Bongorian/chiptune-usb-cv/docs/routing-notes.txt

配線方針 — JLCPCB Economic PCBA / 4層 FR4 1.6 mm / 外層銅 1 oz・内層銅 0.5 oz
2026-10-05

JLCPCB公表値と設計値
- 外層1 ozの最小線幅・線間隔は0.10 mm。設計の絶対最小は0.15 mm。
- 通常の銅間隔0.15 mm、CV・音声0.20 mm、絶縁側MIDI0.50 mm。
- 基板外周から銅まで0.50 mm。四隅R3と角中心のM2穴は維持。
- 通常ビアは外径0.60 / 穴0.30 mm、電源ビアは0.80 / 穴0.40 mm。
  RP2040・共有データバス・局所GNDの引き出し用は外径0.50 / 穴0.20 mm (環状銅0.15 mm)。
- ビアは表裏ともテンティング。SMDランド内のビア穴は禁止。
- PTH環状銅幅0.18 mm以上、部品穴同士0.45 mm以上。
- 部品実装は表面1面のEconomicを想定。DIP音源IC・OLEDは手実装。

信号グループ別の基本配線幅 (mm)
USB D+/D− 0.25、ペア間隔0.15
パラレルデータ・制御 0.15
QSPI 0.15
GPIO→33Ωのクロック支線 0.15、33Ω→音源のクロック 0.20
水晶 0.15 (銅間隔0.20)
CV・バッファ・ADC入力 0.25 (銅間隔0.20)
音声・ミキサー 0.25 (銅間隔0.20)
ライン出力 0.30 (銅間隔0.20)
MIDI絶縁側 0.25 (銅間隔0.50)
ゲート 0.20
3.2 Vロジック 0.45、1.1 Vコア 0.35
音源5 V幹線 0.75、アナログ5 V 0.50
USB VBUS幹線 1.00、昇圧SW 0.75
GND幹線 0.50、端子からGND面への短い接続は0.25。内層2をGND面とし表裏GND面を併用
その他低電流デジタル信号 0.15

局所的な幅の縮小
- 細ピッチICとUSB-C端子を出る部分のみ0.15 mm以上を許可。
- TPS61023のVINは低電流のICバイアス支線。専用領域だけ0.25 mm以上。
- USB保護素子・LDOのVBUS端子支線は0.25 mm以上。
- 基本幅と局所縮小は.kicad_pro/.kicad_druに保存。
- 配線対象96ネットと未使用18端子の個別ネットを19クラスに分類。
- 全ネットの指定幅・実際の幅・配線長・ビア数は outputs/routing-widths.csv に記録。

優先配線
- 共有D0..D7は音源ソケット間を裏面の平行配線で接続し、ソケット端子からは表面で引き出す。
- SAA1099 pin10..17のデータは基板D7..D0へ接続。GPIO0..7は基板D7..D0へ接続。
  GPIOの8bitポート出力値は論理バイトそのまま。個別PIN_Dn書込み用はreverse8。
  firmware/sound_bus.h に両方の書き込み用ヘルパーを定義。
- USB-Cの裏表両接点→ESD→27 Ω→RP2040を先に配線。
- 水晶は表面のみで接続し、信号ビア0。水晶直下の裏面と内層1に信号・ビア禁止領域を設ける。
- 外形配置を維持しながらY1を180度回転し、R1/R27の同寸法本体の位置を交換。
  同じ15 pFのC1/C2の接続先も交換して、水晶配線の交差を解消。
- 昇圧SW配線と入出力コンデンサの電流ループを先に確保。
- 水晶Y1のGND端子4とC19/C13/R6のGNDはベタの細い橋に頼らず、端子から内層GND面まで明示的に接続。
- GND面は最終配線後に再充填し、信号線・ビア・穴に対する間隔を検査。

確認範囲
USBの0.25 mm幅/0.15 mm間隔はこの4層板の配線寸法目標。
90 Ωの製造保証や電磁界解析による保証を意味しない。JLCPCBの
インピーダンス管理サービスは4層以上が対象。USBはFull Speed用途。
層構成は F.Cu（部品・信号）、In1.Cu（信号）、In2.Cu（GND）、B.Cu（信号・GND）。
4層化により2層版より基板製造費が上がる。2層途中版は variants/usb-cv-2layer-routing/ に保存。
DRC 0、未接続0、回路図一致0、ERC 0を確認。
GerberとPCBA下書きは outputs/jlcpcb/。部品選択・回転・在庫は発注前にプレビューで確認。
実機ファームウェア、試作による電源・音声・CV校正の評価は未完了。

公式資料
https://jlcpcb.com/capabilities/pcb-capabilities/
https://jlcpcb.com/capabilities/pcb-assembly-capabilities
