Bongorian/chiptune-usb-cv/mechanical/previews/mechanical_drawing.pdf

# CHIPTUNE USB/CV / ENCLOSURE

Dimensions in mm / diagram not to scale / drawing-only annotations

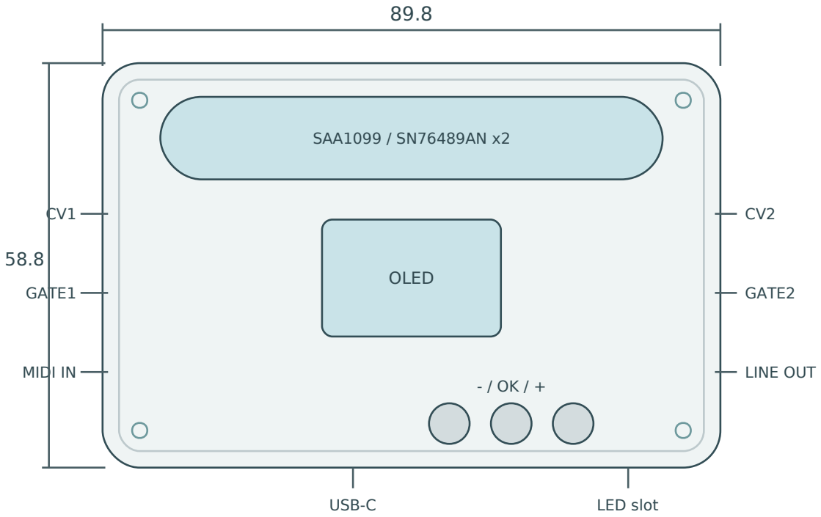
[picture p3: figure]
GATE1; MIDI IN; GATE2; LINE OUT; USB-C; LED slot; SAA1099 / SN76489AN x2; OLED

TOP / PCB hole centres: (3,3), (82,3), (3,51), (82,51)
Four M2 x 10 screws from the underside; heat-set inserts in lid posts. Blue circles: PCB holes, hidden under the assembled lid.

23

SIDE / TRS relief: diameter 9.5 Port pitch: 11.5 / seam at jack axis

### HEIGHT STACK

PCB bottom: 6.0

OLED bottom: 12.6

Open bezel: 19.0 - 21.0

Separate OLED module on 5 mm PCB spacers

## FIT COUPON / 58 x 16 x 5

2.9 | 3.0 | 3.1 | 3.2 | 3.3
5.7 | 5.9 | 6.1

Blind holes: insert pilot diameters Through holes: button guide diameters

## PRINT PARTS

Base x1 / bottom on bed
Lid x1 / exterior face on bed
Button cap x3 / head face on bed Open IC / OLED apertures; no covers Case M2 inserts: OD 3.5, length 3.0

Prototype fit required: insert bore, switch travel, socket height and actual module dimensions.
