Bongorian/chiptune-usb-cv/firmware/LEVELS_AND_PITCH.md

# v0.10 音量と音程の確認

初期配置は `MIDI 10`。MIDI ch1–6はSAAの各1音、ch7–9は左右SNの同番号トーンの各1音、ch10は左右SNのノイズ1音です。各chは単音で、SNは同じノートをL/Rへ送ります。PAN中央で両側同音量、CC10でL/Rの音量比を変えます。SAAもCC10で左右へ振れます。通常のMIDI受信音程を下げる移調は入れていません。

## 音程

`src/sound_math.c`の1/256半音LUTを単一エンジンで使用し、SAAは専用レジスターLUTへ変換します。MIDI note 0=C-1、69=A4=440 Hz。オクターブ番号はDAWによって異なるため、試聴時はノート番号とHzも確認してください。初期試聴はnote 45=A2=110 Hzです（従来は48=C3=130.81 Hz）。初期音色SAA TONE／SN MONOは移調0、スイープ0、ビブラート0、デチューン0です。ENVやSN STACKから始まって音程の意味が変わる構成をやめました。

回路の基準クロックはSAA=8 MHz、SN初期値=2 MHzです。RP2040=128 MHz、SAA PWMのwrap=15、SNのPIO分周設定と照合しています。SNクロックFXを有効にすると意図的に音程が変化します。

| 音源 | 出力周波数 | 初期クロックでの範囲 |
|---|---|---|
| SAA通常トーン | `8,000,000 × 2^octave / [512 × (511 − register)]` | 約30.58–7,812.5 Hz。MIDI 23–118が範囲内 |
| SN通常トーン | `clock / (32 × divider)` | 2 MHzでは約61.09 Hz以上。MIDI 35以上が範囲内 |
| 純SAA ENV | 上記のENVクロックを形状・段数で分周 | 通常トーンと異なる。16段三角の上限約488 Hz |
| SN PULSE（Periodic＋Tone 3） | `clock / (32 × Tone3 divider × 15)`、パルス幅約1/15固定 | 2 MHzでは約4.07–4,166.7 Hz。高音域の分周誤差が増える |
| SNホワイトノイズ | 固定レート、または音程からノイズの更新速度へ変換 | 楽音の基音は保証しない |

通常トーンの分周式には一律1オクターブの誤りは見つかりませんでした。基準テーブルを共通化し、110/130.8128/261.6256/440/880 Hzと全128ノートの換算、SAAの範囲内誤差4 cent未満を回帰テストに追加しました。範囲外は最小／最大へのクランプを維持します。SNの高音域では10 bit分周の量子化誤差が大きくなります。

実装から出力した[128ノートの周波数表](dist/Pitch_Table.csv)にレジスター値・実際の計算周波数・cent誤差・クランプ有無を収録します。SN PULSE用のTone 3分周値・周期周波数・誤差も併記します。再生成はホストビルド後に `build/tests/pitch_export > firmware/dist/Pitch_Table.csv`。

## 音量補正の根拠

資料は[Philips/Mullard SAA1099、1984年8月](https://sam.speccy.cz/systech/saa-1099_data_sheet.pdf)のp.4–8、11–15、および[TI SN76489AN](https://map.grauw.nl/resources/sound/texas_instruments_sn76489an.pdf)のTone Generators、Electrical Characteristics、Fig.2です。回路は `routed/Chiptune_USB_CV.kicad_pcb` と生成元 `scripts/design.py` のオーディオ段を照合します。

- SAA：IREF抵抗10 kΩ、左右負荷1.5 kΩ。R42=10 kΩ、R43/R44=1.5 kΩを基板データでも確認。各出力から1 µF＋22 kΩでミキサーへ入り、帰還抵抗10 kΩ。公称IREF=250 µAを置くと、1音最大時の片側出力は `250 µA × 1.5 kΩ × 10 kΩ / (22 kΩ + 1.5 kΩ) ≈ 0.1596 Vpp`。1.5 kΩの出力抵抗による入力22 kΩへの負荷を含みます。
- SN：Fig.2の内部合計電流160 µAと17 kΩ帰還、4つの等重み音源から、1音の公称振幅を `160 µA / 4 × 17 kΩ = 0.68 Vpp` と推定します。外部ミキサー後は `0.68 × 10/22 ≈ 0.3091 Vpp`。
- よってSNの線形ゲインに `0.1596/0.3091 ≈ 0.51627`（約−5.74 dB）を掛けてから2 dB刻みへ量子化します。フルスケールでは約−6 dBになります。SAAは直線16段階です。音色LEVEL、ベロシティ、ADSR、CC7/11、PANとチップミックスを掛けた後、最終レジスターへ変換します。

**これは公称モデルでの合わせ込みで、実機の同音量を保証する値ではありません。** SAAの10 kΩによるIREFは個体差があり、データシートの1音電流は155–270 µAです。SNのFig.2は絶対音量の保証規格ではありません。波形・ノイズ・ENVのRMSと聴感も同一ではありません。1.5 kΩ負荷はSAAの同時発音時のコンプライアンスも実機確認が必要です。ファームウェアでアナログ段の飽和や抵抗値の問題を解消することはできません。

旧版のSAA 80/SN 70というチップミックスの差は新初期配置で100/100へそろえ、補正を一箇所へ集めます。MASTERは70、音色LEVELは65のままです。PAN中央ではSAAとSNを**片側の出力レベル**で比較します。中央から端へ動かす途中はセンター減衰なしPANです。

## 実機での詰め方

1. MIDI 10でch1 SAA TONEとch7 SN MONOを別々に鳴らす。note 69、velocity 127、CC7/11=127、CC10=64。LEVEL/SUSTAIN=100、ATTACK/DECAY=0、変調OFFにそろえる。
2. 同じ負荷（10 kΩ以上）でLINE OUTの片側ずつを測定する。440 Hzの基本周期、VppとAC RMSを記録する。L/Rとも確認する。
3. SNの補正係数は `新係数 = 現係数 × SAA実測RMS / SN実測RMS`。CMakeの `CHIPTUNE_SN1_TRIM`（左）／`CHIPTUNE_SN2_TRIM`（右）で独立指定し再ビルドする。例 `-DCHIPTUNE_SN1_TRIM=0.50f`。2 dB刻みのため細かな差は残る。音色のLEVELは用途に合わせて調整する。
4. 全ch同時、低音、高音、PAN両端、ENVとノイズでも飽和・音切れ・左右差を確認する。

PCテストは送出レジスターと公称モデルを検証します。実機での出力測定・聴感比較は未実施です。
