Bongorian/chiptune-usb-cv/firmware/assets/oled-screens.png

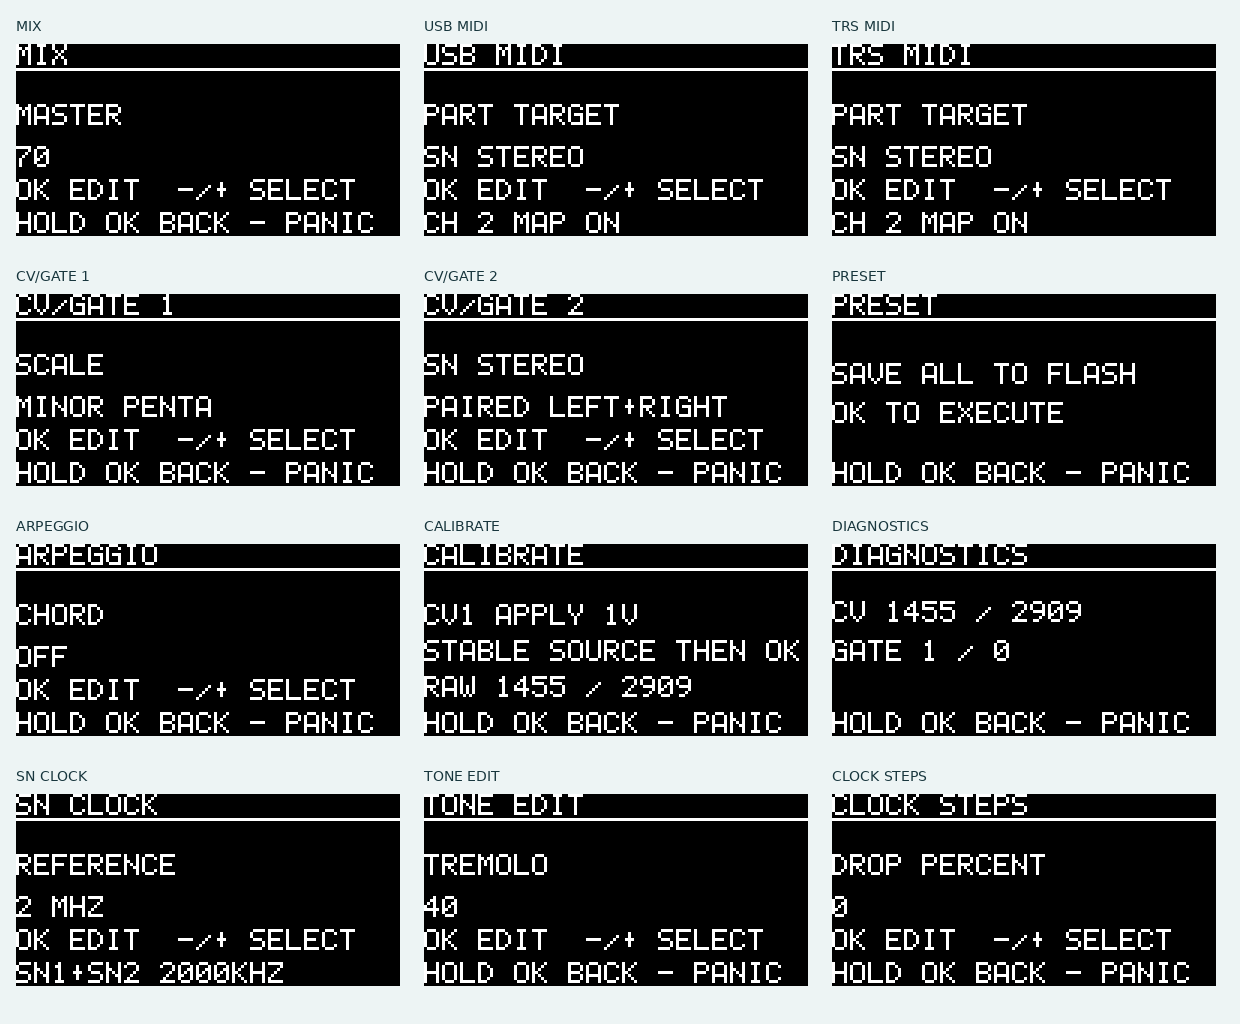
firmware/assets/oled-screens.png
