Bongorian/chiptune-usb-cv/firmware/assets/ui-v05.png

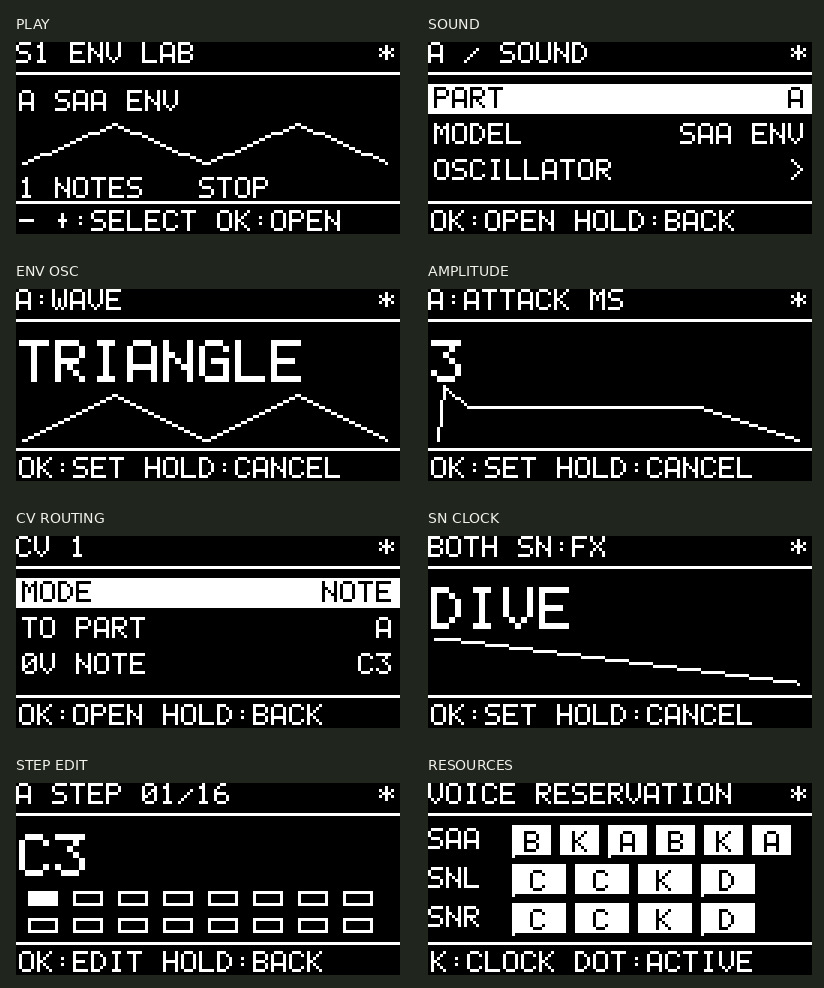
firmware/assets/ui-v05.png
