Bongorian/chiptune-usb-cv/firmware/assets/ui-v06.png

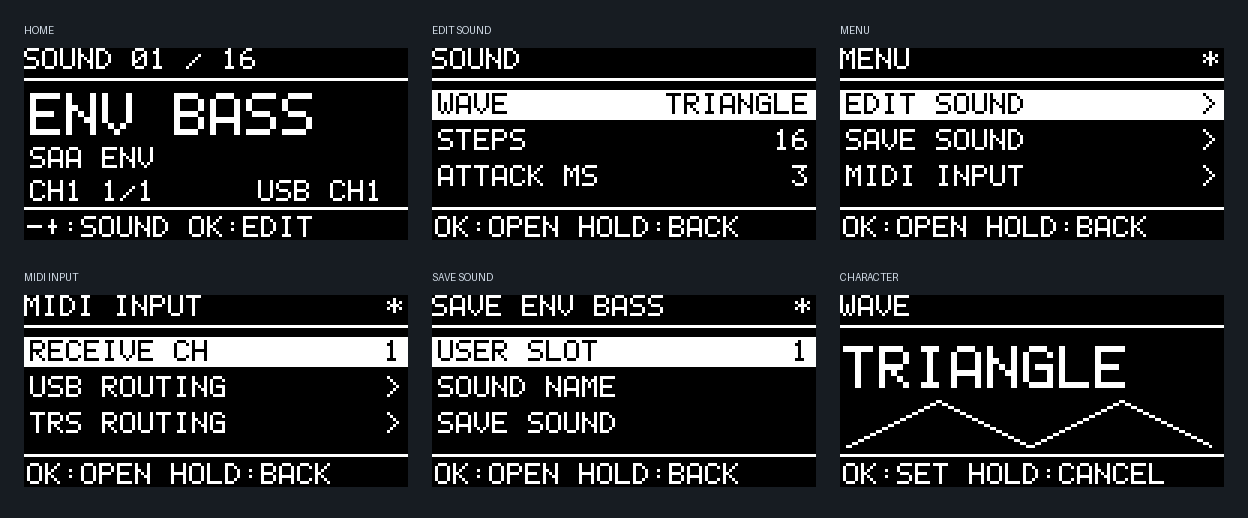
firmware/assets/ui-v06.png
