Bongorian/chiptune-usb-cv/firmware/assets/ui-v07.png

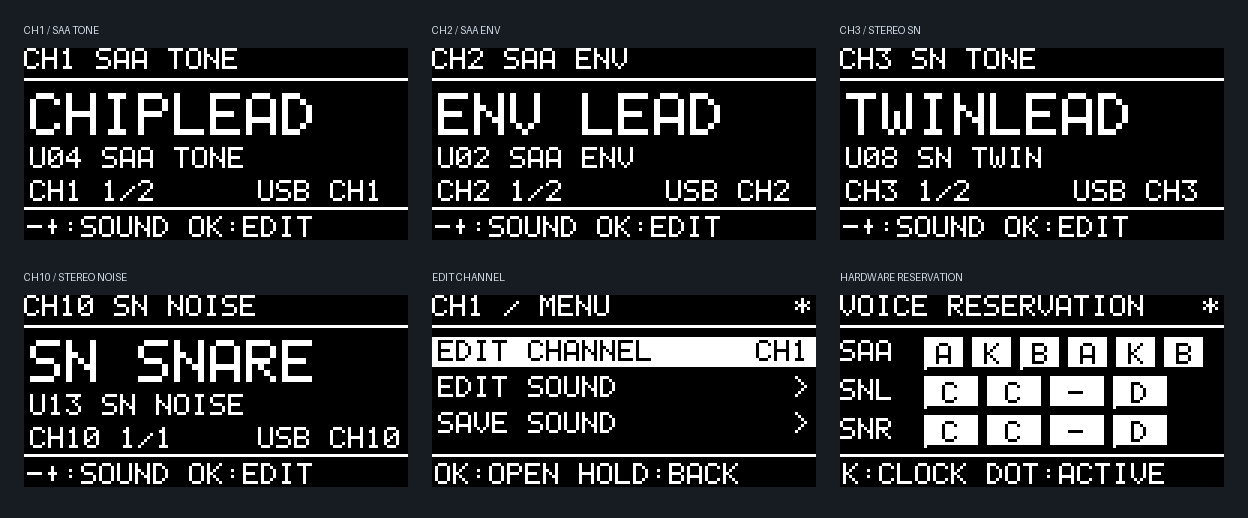
firmware/assets/ui-v07.png
