Bongorian/chiptune-usb-cv/firmware/assets/ui-v08.png

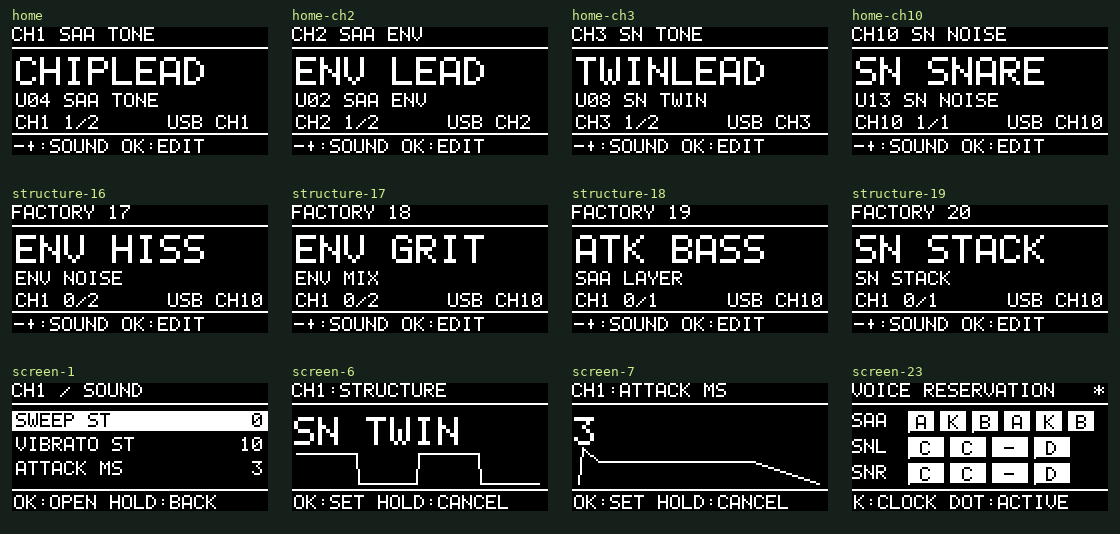
firmware/assets/ui-v08.png
