Bongorian/chiptune-usb-cv/firmware/assets/ui-v09.png

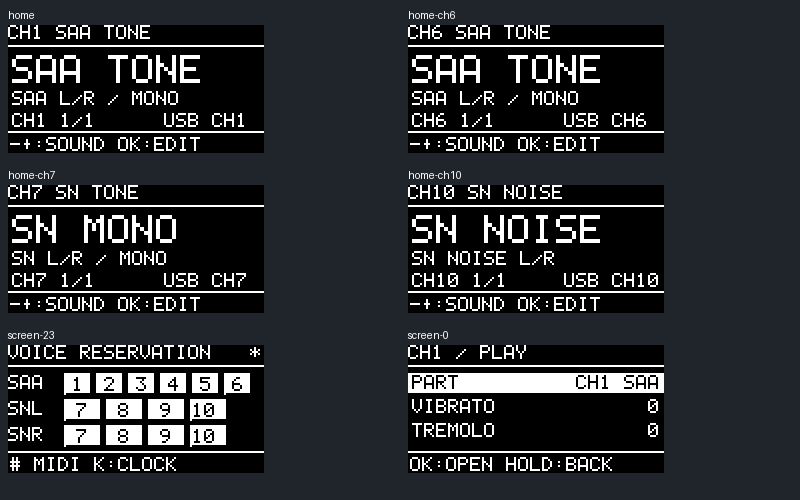
firmware/assets/ui-v09.png
