Bongorian/chiptune-usb-cv/firmware/assets/ui-v10.png

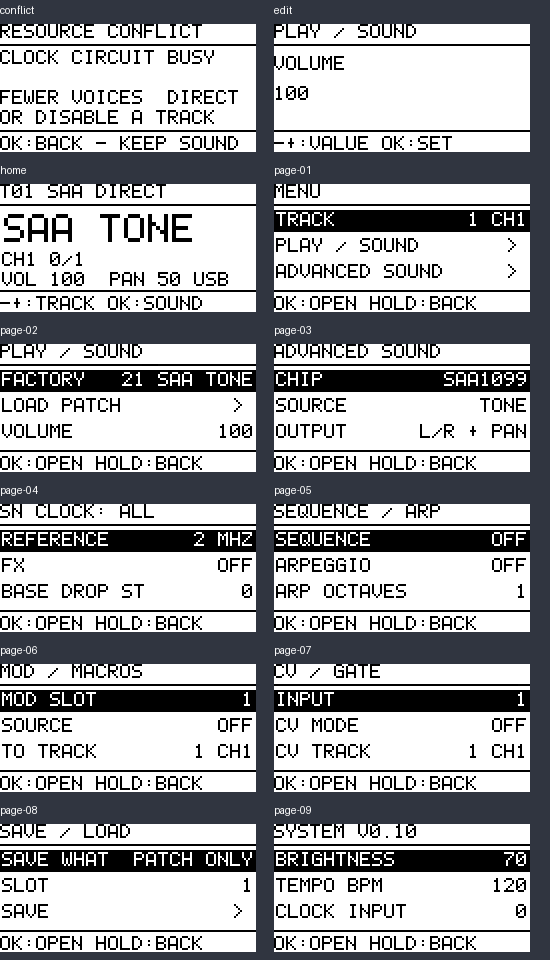
firmware/assets/ui-v10.png
