Bongorian/chiptune-usb-cv/firmware/assets/ui-waves-v10.png

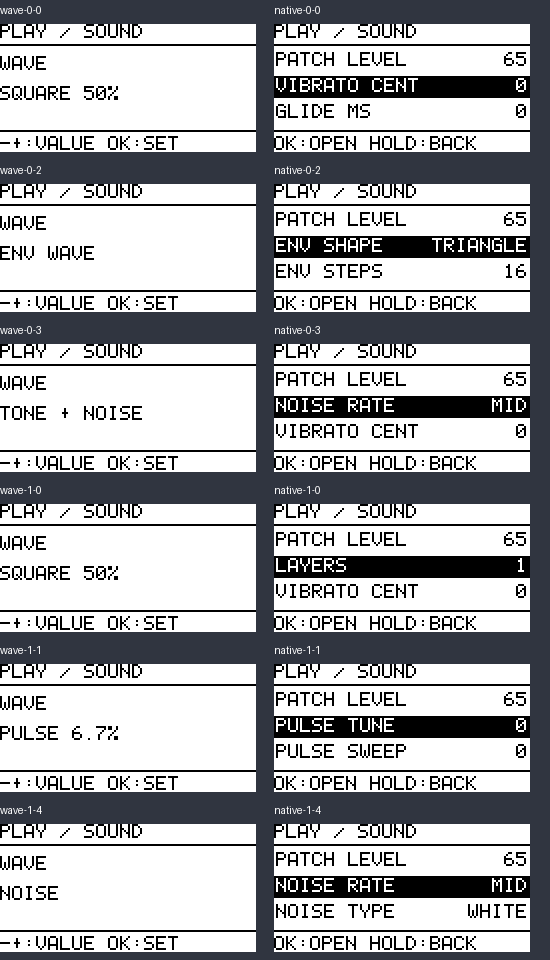
firmware/assets/ui-waves-v10.png
