Bongorian/chiptune-usb-cv/mechanical/previews/base_inside.png

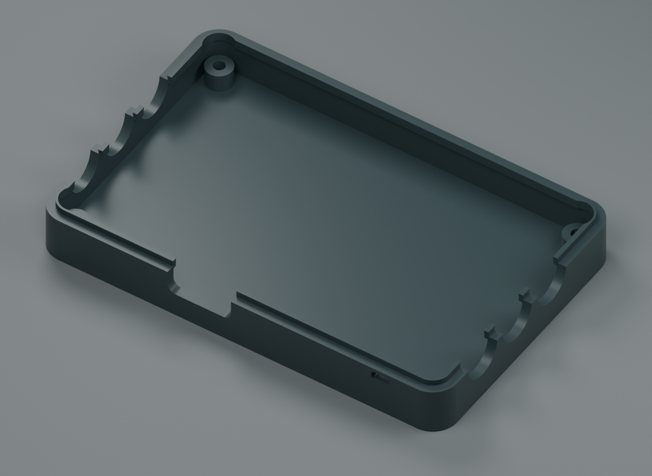
mechanical/previews/base_inside.png
