Bongorian/chiptune-usb-cv/mechanical/previews/exploded.png

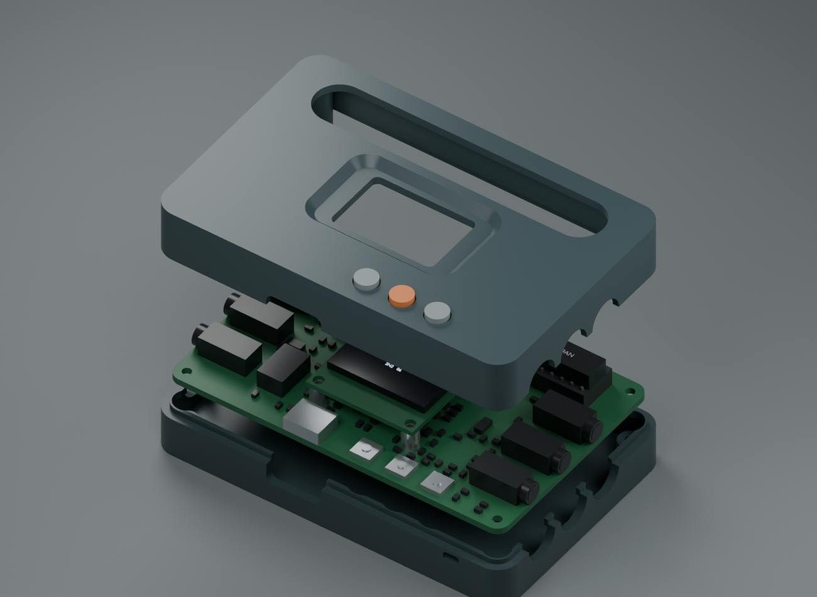
mechanical/previews/exploded.png
