Bongorian/chiptune-usb-cv/mechanical/previews/mechanical_drawing.png

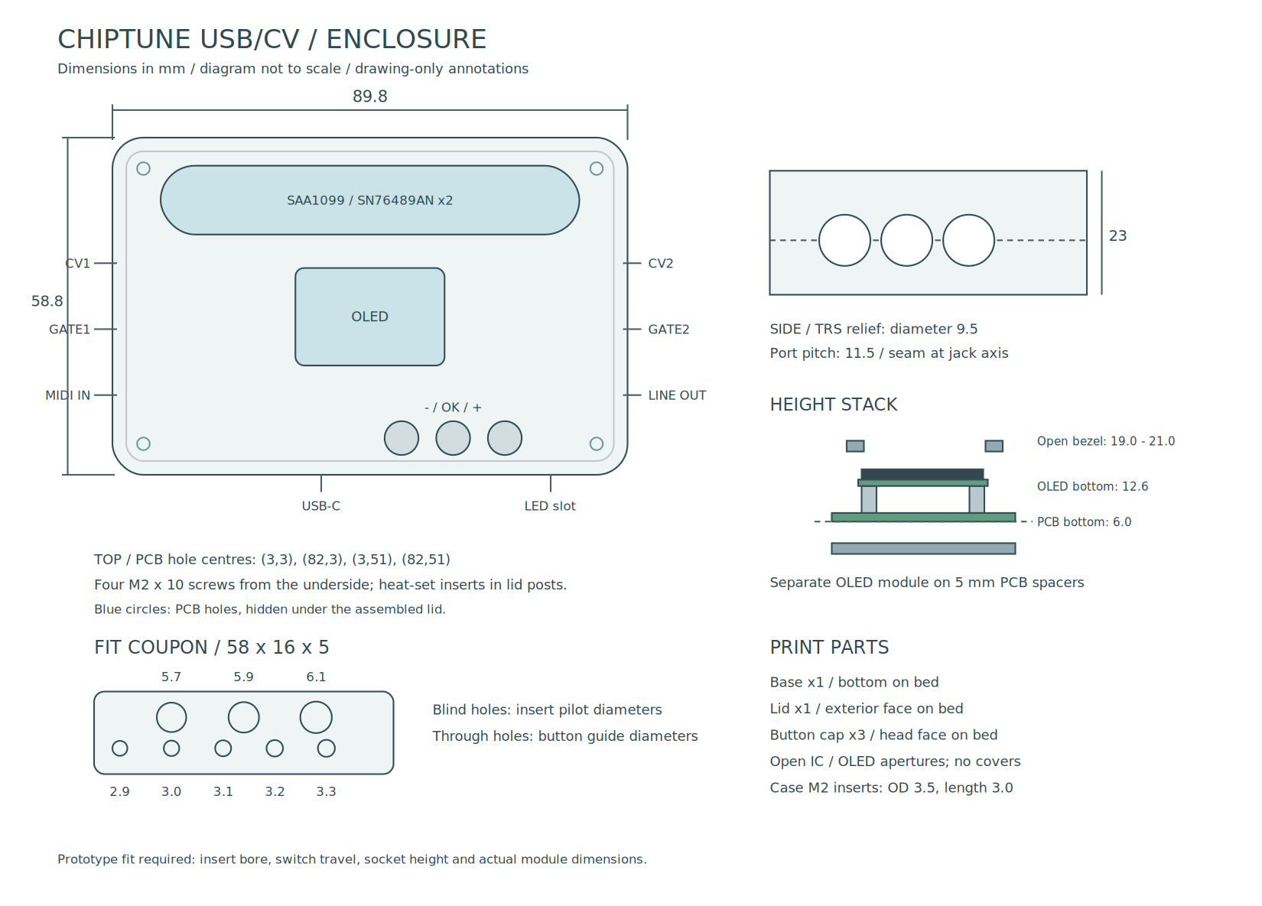
mechanical/previews/mechanical_drawing.png
