Bongorian/chiptune-usb-cv/mechanical/previews/top.png

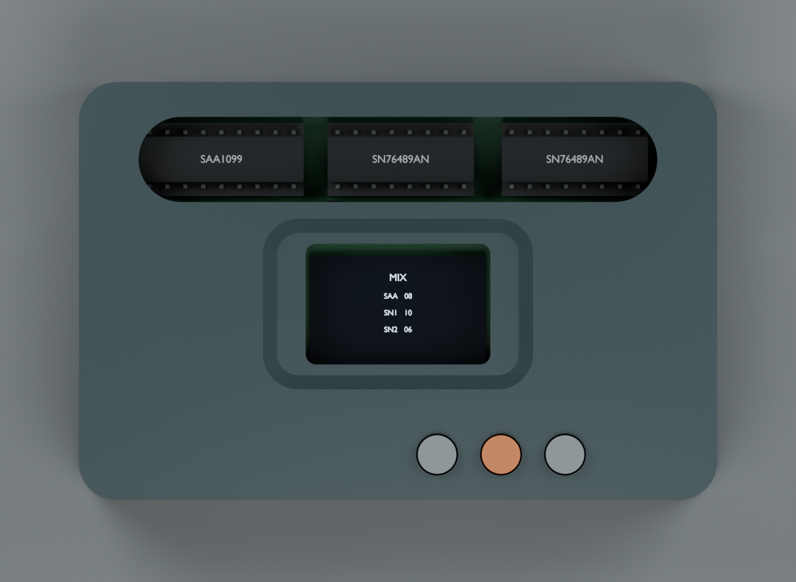
mechanical/previews/top.png
