Bongorian/chiptune-usb-cv/outputs/jlc-one/reference/Placement_Pin1.png

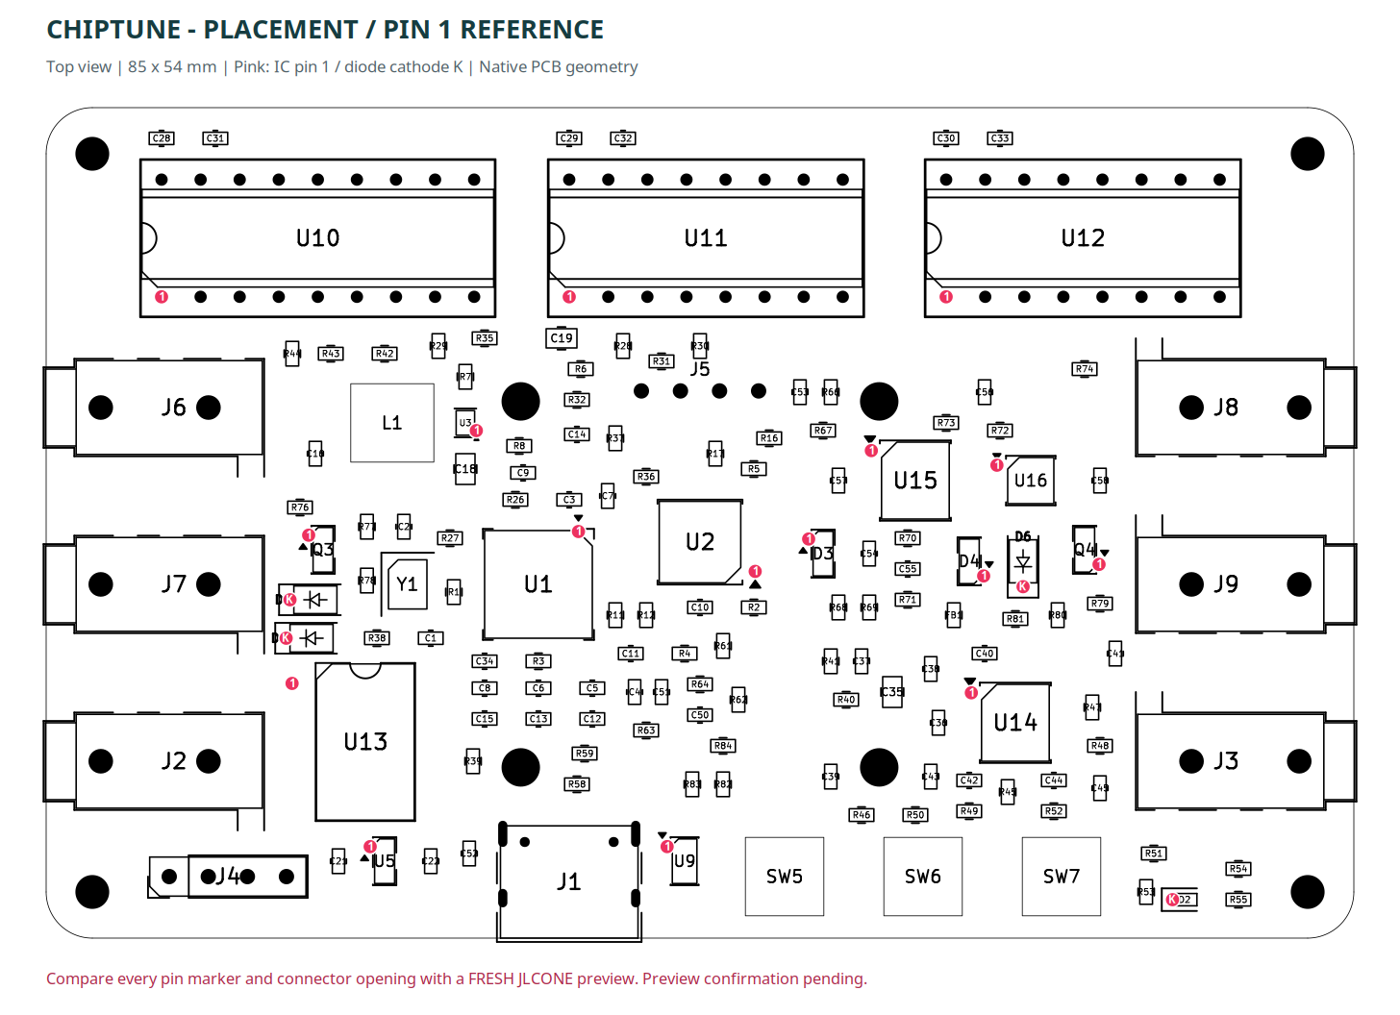
outputs/jlc-one/reference/Placement_Pin1.png
