Bongorian/chiptune-usb-cv/outputs/review/routing-ground.png

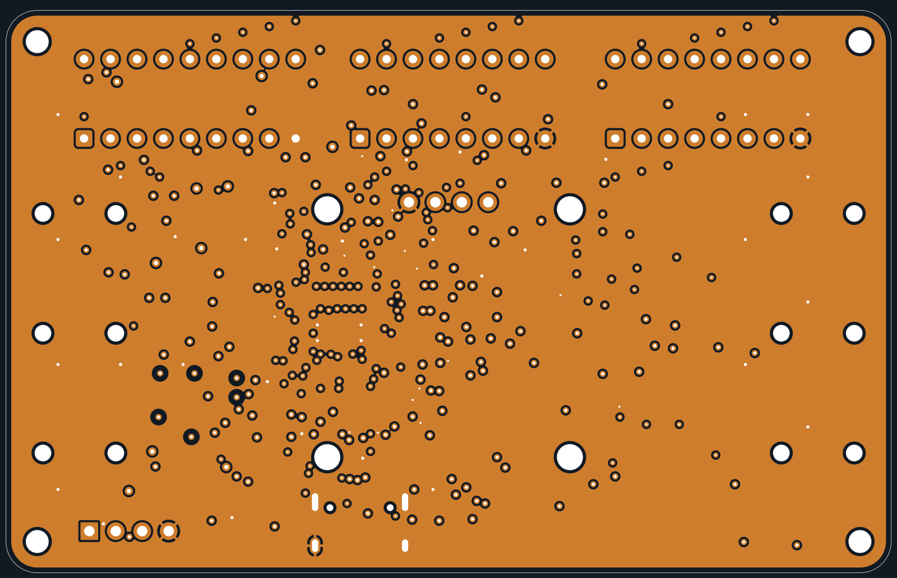
outputs/review/routing-ground.png
