Bongorian/chiptune-usb-cv/outputs/review/routing-inner1.png

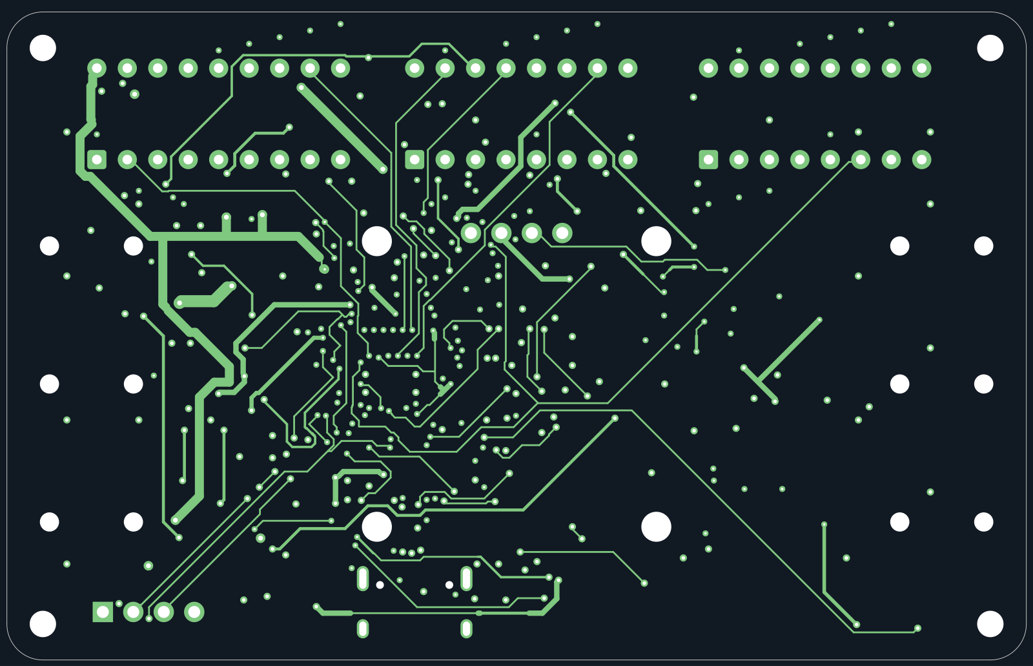
outputs/review/routing-inner1.png
