Bongorian/chiptune-usb-cv/outputs/review/routing-traces-back.png

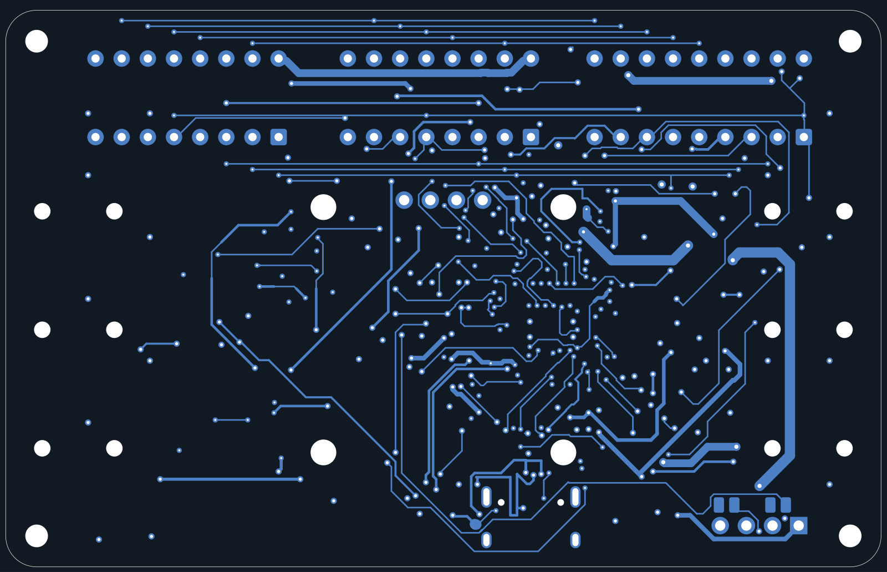
outputs/review/routing-traces-back.png
