Bongorian/chiptune-usb-cv/outputs/review/routing-traces-front.png

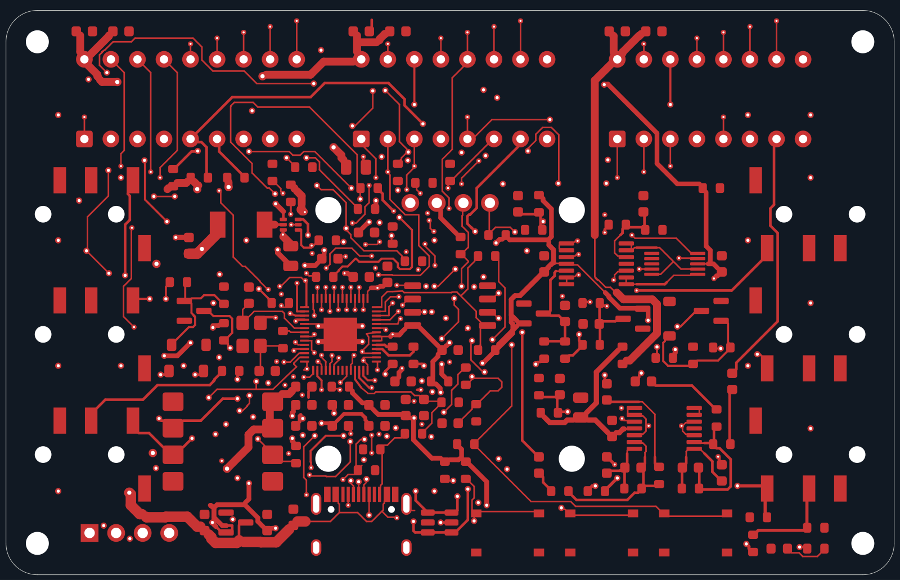
outputs/review/routing-traces-front.png
