Bongorian/chiptune-usb-cv/outputs/review/rp2040-closeup.png

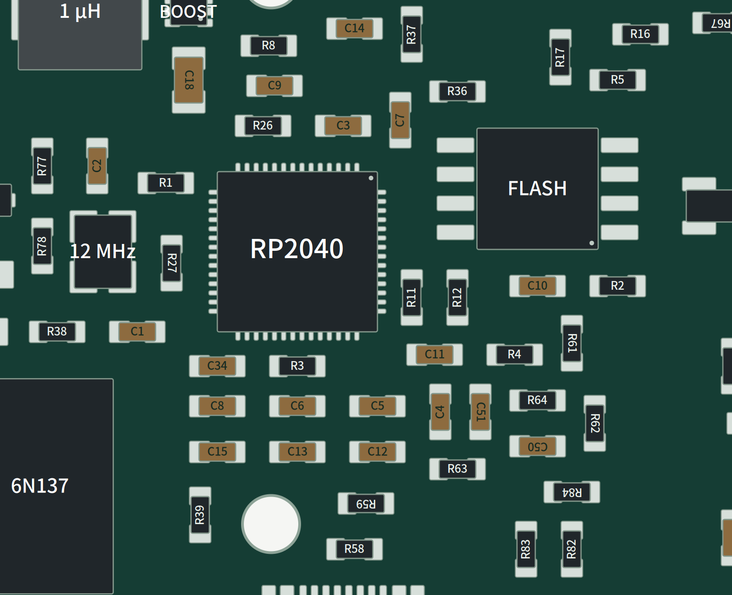
outputs/review/rp2040-closeup.png
