Bongorian/chiptune-usb-cv/outputs/review/signal-flow-placement.png

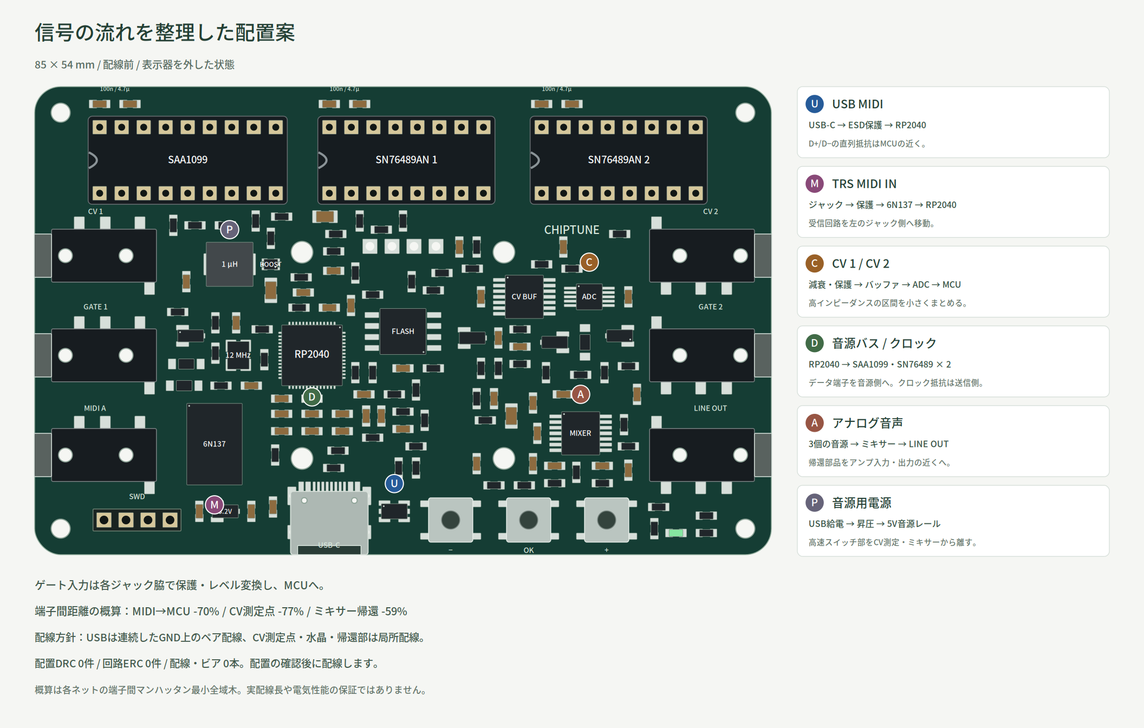
outputs/review/signal-flow-placement.png
