Bongorian/chiptune-usb-cv/outputs/engineering_bom.csv

Reference | Value | Footprint | LCSC | Side | Notes
U1 | RP2040 | Chiptune:Board_U1 | C2040 | F
U2 | W25Q16JVSSIQ | Chiptune:Board_U2 | C131025 | F
Y1 | ABM8-272-T3 12MHz | Chiptune:Board_Y1 | C20625731 | F
R1 | 1k | Chiptune:Board_R1 | C21190 | F
C1 | 15p C0G | Chiptune:Board_C1 | C1644 | F
C2 | 15p C0G | Chiptune:Board_C2 | C1644 | F
R2 | 10k | Chiptune:Board_R2 | C25804 | F
R3 | 10k | Chiptune:Board_R3 | C25804 | F
C3 | 100n | Chiptune:Board_C3 | C14663 | F
C4 | 100n | Chiptune:Board_C4 | C14663 | F
C5 | 100n | Chiptune:Board_C5 | C14663 | F
C6 | 100n | Chiptune:Board_C6 | C14663 | F
C7 | 100n | Chiptune:Board_C7 | C14663 | F
C8 | 100n | Chiptune:Board_C8 | C14663 | F
C9 | 100n | Chiptune:Board_C9 | C14663 | F
C10 | 100n | Chiptune:Board_C10 | C14663 | F
C11 | 100n | Chiptune:Board_C11 | C14663 | F
C12 | 100n | Chiptune:Board_C12 | C14663 | F
C13 | 100n | Chiptune:Board_C13 | C14663 | F
C14 | 1u | Chiptune:Board_C14 | C15849 | F
C15 | 1u | Chiptune:Board_C15 | C15849 | F
R4 | 10R | Chiptune:Board_R4 | C22859 | F
R5 | 1k | Chiptune:Board_R5 | C21190 | F
J4 | SWD | Chiptune:Board_J4 |  | F | Hand solder, optional
U3 | TPS61023DRLR | Chiptune:Board_U3 | C919459 | F
R6 | 100k | Chiptune:Board_R6 | C25803 | F
L1 | SLO0520H1R0MTT 1uH | Chiptune:Board_L1 | C325980 | F | 1uH; Isat 8A typ, Irms 5A typ; manufacturer drawing verified
C16 | 1u | Chiptune:Board_C16 | C15849 | F
C18 | 22u 25V | Chiptune:Board_C18 | C45783 | F
C19 | 22u 25V | Chiptune:Board_C19 | C45783 | F
R7 | 22k | Chiptune:Board_R7 | C31850 | F
R8 | 3k | Chiptune:Board_R8 | C4211 | F
U5 | AP2120N-3.2TRG1 | Chiptune:Board_U5 | C6500828 | F | 3.2V +/-2%; OLED maximum 3.3V
C21 | 4.7u 16V | Chiptune:Board_C21 | C19666 | F
C22 | 4.7u 16V | Chiptune:Board_C22 | C19666 | F
J1 | USB-C MIDI DEVICE / POWER | Chiptune:Board_J1 | C165948 | F
U9 | USBLC6-2SC6 | Chiptune:Board_U9 | C7519 | F
R11 | 27R | Chiptune:Board_R11 | C25190 | F
R12 | 27R | Chiptune:Board_R12 | C25190 | F
R16 | 4.7k | Chiptune:Board_R16 | C23162 | F
R17 | 4.7k | Chiptune:Board_R17 | C23162 | F
U10 | SAA1099 DIP18 | Chiptune:Board_U10 |  | F | User supplied IC; hand solder DIP18 socket; GPIO0..7 word equals logical byte; reverse8 only for individual PIN_Dn writes
U11 | SN76489AN DIP16 | Chiptune:Board_U11 |  | F | User supplied IC; hand solder DIP16 socket; READY unused, firmware write wait >=10us at 4MHz
U12 | SN76489AN DIP16 | Chiptune:Board_U12 |  | F | User supplied IC; hand solder DIP16 socket; READY unused, firmware write wait >=10us at 4MHz
R26 | 33R | Chiptune:Board_R26 | C23140 | F
R27 | 33R | Chiptune:Board_R27 | C23140 | F
R28 | 100k | Chiptune:Board_R28 | C25803 | F
R29 | 100k | Chiptune:Board_R29 | C25803 | F
R30 | 100k | Chiptune:Board_R30 | C25803 | F
R31 | 100k | Chiptune:Board_R31 | C25803 | F
R32 | 10k | Chiptune:Board_R32 | C25804 | F
R35 | 100k | Chiptune:Board_R35 | C25803 | F
R36 | 100k | Chiptune:Board_R36 | C25803 | F
R37 | 100k | Chiptune:Board_R37 | C25803 | F
C28 | 100n | Chiptune:Board_C28 | C14663 | F
C29 | 100n | Chiptune:Board_C29 | C14663 | F
C30 | 100n | Chiptune:Board_C30 | C14663 | F
C31 | 4.7u 16V | Chiptune:Board_C31 | C19666 | F
C32 | 4.7u 16V | Chiptune:Board_C32 | C19666 | F
C33 | 4.7u 16V | Chiptune:Board_C33 | C19666 | F
J2 | TRS MIDI IN TYPE A | Chiptune:Board_J2 | C95562 | F
R38 | 220R | Chiptune:Board_R38 | C22962 | F
D1 | 1N4148W | Chiptune:Board_D1 | C81598 | F
U13 | 6N137S(T1) | Chiptune:Board_U13 | C191867 | F
R39 | 2.2k | Chiptune:Board_R39 | C4190 | F
C34 | 100n | Chiptune:Board_C34 | C14663 | F
U14 | TLV9004IPWR | Chiptune:Board_U14 | C2058050 | F
FB1 | 10R analog RC filter | Chiptune:Board_FB1 | C22859 | F
C35 | 22u 25V | Chiptune:Board_C35 | C45783 | F
C36 | 100n | Chiptune:Board_C36 | C14663 | F
R40 | 10k | Chiptune:Board_R40 | C25804 | F
R41 | 10k | Chiptune:Board_R41 | C25804 | F
C37 | 4.7u 16V | Chiptune:Board_C37 | C19666 | F
R42 | 10k | Chiptune:Board_R42 | C25804 | F
R43 | 1.5k | Chiptune:Board_R43 | C22843 | F
R44 | 1.5k | Chiptune:Board_R44 | C22843 | F
C38 | 1u | Chiptune:Board_C38 | C15849 | F
R45 | 22k | Chiptune:Board_R45 | C31850 | F
C39 | 1u | Chiptune:Board_C39 | C15849 | F
R46 | 22k | Chiptune:Board_R46 | C31850 | F
C40 | 1u | Chiptune:Board_C40 | C15849 | F
R47 | 22k | Chiptune:Board_R47 | C31850 | F
C41 | 1u | Chiptune:Board_C41 | C15849 | F
R48 | 22k | Chiptune:Board_R48 | C31850 | F
R49 | 10k | Chiptune:Board_R49 | C25804 | F
C42 | 470p X7R | Chiptune:Board_C42 | C1620 | F
C43 | 10u 10V | Chiptune:Board_C43 | C19702 | F
R50 | 100R | Chiptune:Board_R50 | C22775 | F
R51 | 100k | Chiptune:Board_R51 | C25803 | F
R52 | 10k | Chiptune:Board_R52 | C25804 | F
C44 | 470p X7R | Chiptune:Board_C44 | C1620 | F
C45 | 10u 10V | Chiptune:Board_C45 | C19702 | F
R53 | 100R | Chiptune:Board_R53 | C22775 | F
R54 | 100k | Chiptune:Board_R54 | C25803 | F
J3 | STEREO LINE OUT | Chiptune:Board_J3 | C95562 | F
D2 | RED STATUS | Chiptune:Board_D2 | C2286 | F | Basic red status LED; same 0603 K/A footprint; R55 2.2k unchanged; selected for cost.
R55 | 2.2k | Chiptune:Board_R55 | C4190 | F
R58 | 5.1k | Chiptune:Board_R58 | C23186 | F
R61 | 100k | Chiptune:Board_R61 | C25803 | F
R62 | 100k | Chiptune:Board_R62 | C25803 | F
C50 | 100n | Chiptune:Board_C50 | C14663 | F
R59 | 5.1k | Chiptune:Board_R59 | C23186 | F
R63 | 100k | Chiptune:Board_R63 | C25803 | F
R64 | 100k | Chiptune:Board_R64 | C25803 | F
C51 | 100n | Chiptune:Board_C51 | C14663 | F
C52 | 1u | Chiptune:Board_C52 | C15849 | F
U15 | TLV9004IPWR CV BUFFER | Chiptune:Board_U15 | C2058050 | F
U16 | ADS1115IDGSR | Chiptune:Board_U16 | C37593 | F
R66 | 10k | Chiptune:Board_R66 | C25804 | F
R67 | 10k | Chiptune:Board_R67 | C25804 | F
C53 | 100n | Chiptune:Board_C53 | C14663 | F
R68 | 100k 0.1% | Chiptune:Board_R68 | C855559 | F
R69 | 10k 0.1% | Chiptune:Board_R69 | C95204 | F
C54 | 100n | Chiptune:Board_C54 | C14663 | F
D3 | BAT54S | Chiptune:Board_D3 | C83935 | F
R70 | 100k 0.1% | Chiptune:Board_R70 | C855559 | F
R71 | 10k 0.1% | Chiptune:Board_R71 | C95204 | F
C55 | 100n | Chiptune:Board_C55 | C14663 | F
D4 | BAT54S | Chiptune:Board_D4 | C83935 | F
R72 | 100k 0.1% | Chiptune:Board_R72 | C855559 | F
R73 | 10k 0.1% | Chiptune:Board_R73 | C95204 | F
C56 | 100n | Chiptune:Board_C56 | C14663 | F
C57 | 100n | Chiptune:Board_C57 | C14663 | F
C58 | 100n | Chiptune:Board_C58 | C14663 | F
R74 | 2.2k | Chiptune:Board_R74 | C4190 | F
Q3 | MMBT3904(RANGE:100-300) | Chiptune:Board_Q3 | C20526 | F | Basic substitution; SOT-23 pin 1 B / 2 E / 3 C; same footprint and wiring.
R76 | 100k | Chiptune:Board_R76 | C25803 | F
R77 | 100k | Chiptune:Board_R77 | C25803 | F
R78 | 10k | Chiptune:Board_R78 | C25804 | F
D5 | 1N4148W | Chiptune:Board_D5 | C81598 | F
Q4 | MMBT3904(RANGE:100-300) | Chiptune:Board_Q4 | C20526 | F | Basic substitution; SOT-23 pin 1 B / 2 E / 3 C; same footprint and wiring.
R79 | 100k | Chiptune:Board_R79 | C25803 | F
R80 | 100k | Chiptune:Board_R80 | C25803 | F
R81 | 10k | Chiptune:Board_R81 | C25804 | F
D6 | 1N4148W | Chiptune:Board_D6 | C81598 | F
J6 | CV1_IN | Chiptune:Board_J6 | C95562 | F
J7 | GATE1_IN | Chiptune:Board_J7 | C95562 | F
J8 | CV2_IN | Chiptune:Board_J8 | C95562 | F
J9 | GATE2_IN | Chiptune:Board_J9 | C95562 | F
J5 | HS96L03W2C03 OLED INTERFACE | Chiptune:Board_J5 | C5248080 | F | Manual assembly; 27.3x27.8mm SSD1315 module on 5mm M2 spacers, not SMT placed
SW5 | UI_MINUS | Chiptune:Board_SW5 | C318884 | F
R82 | 10k | Chiptune:Board_R82 | C25804 | F
SW6 | UI_OK | Chiptune:Board_SW6 | C318884 | F
R83 | 10k | Chiptune:Board_R83 | C25804 | F
SW7 | UI_PLUS | Chiptune:Board_SW7 | C318884 | F
R84 | 10k | Chiptune:Board_R84 | C25804 | F
JP1 | BOOT | Chiptune:Board_JP1 |  | B | Rear service pads; short briefly for BOOT/RESET
JP2 | RESET | Chiptune:Board_JP2 |  | B | Rear service pads; short briefly for BOOT/RESET
