Bongorian/chiptune-usb-cv/mechanical/exports/assembly.step

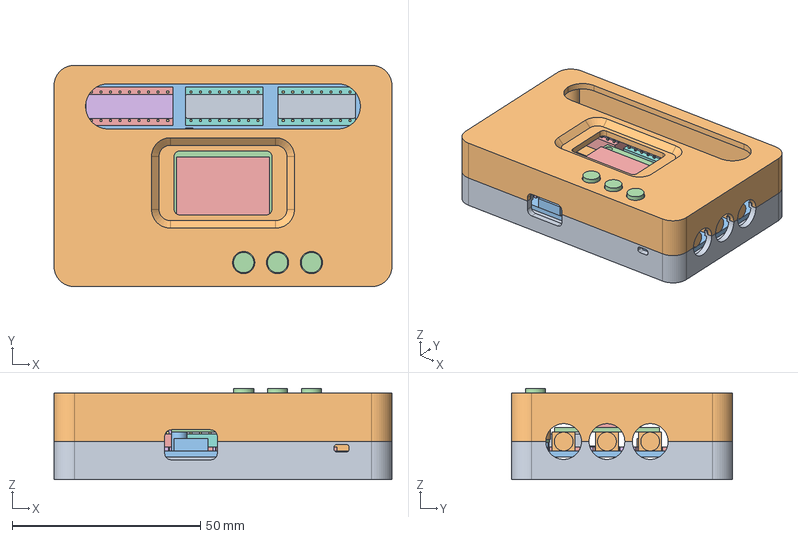
[picture p23: CAD file, 2026-10-05]
mechanical/exports/assembly.step
89.8 x 58.8 x 24.2 mm
base
lid
pcb
button_1
button_2
button_3
U10_socket
U10_chip
U10_lead_0
U10_lead_1
U10_lead_2
U10_lead_3
U10_lead_4
U10_lead_5
U10_lead_6
U10_lead_7
U10_lead_8
U10_lead_9
U10_lead_10
U10_lead_11
U10_lead_12
U10_lead_13
U10_lead_14
U10_lead_15
U10_lead_16
U10_lead_17
U11_socket
U11_chip
U11_lead_0
U11_lead_1
U11_lead_2
U11_lead_3
U11_lead_4
U11_lead_5
U11_lead_6
U11_lead_7
U11_lead_8
U11_lead_9
U11_lead_10
U11_lead_11
U11_lead_12
U11_lead_13
U11_lead_14
U11_lead_15
U12_socket
U12_chip
U12_lead_0
U12_lead_1
U12_lead_2
U12_lead_3
U12_lead_4
U12_lead_5
U12_lead_6
U12_lead_7
U12_lead_8
U12_lead_9
U12_lead_10
U12_lead_11
U12_lead_12
U12_lead_13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
