Bongorian/chiptune-usb-cv/mechanical/exports/fit_coupon.step

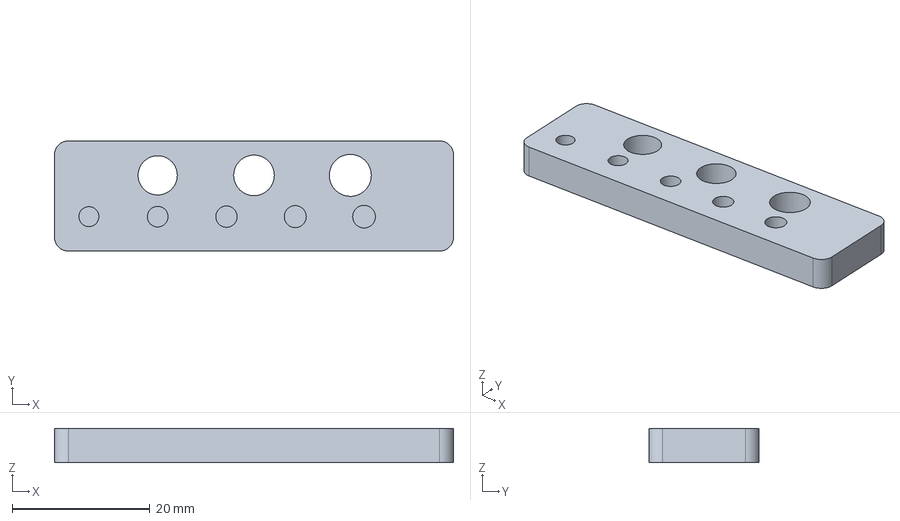
[picture p24: CAD file, 2026-10-05]
mechanical/exports/fit_coupon.step
58.0 x 16.0 x 5.00 mm
