Bongorian/chiptune-usb-cv/mechanical/exports/base.step

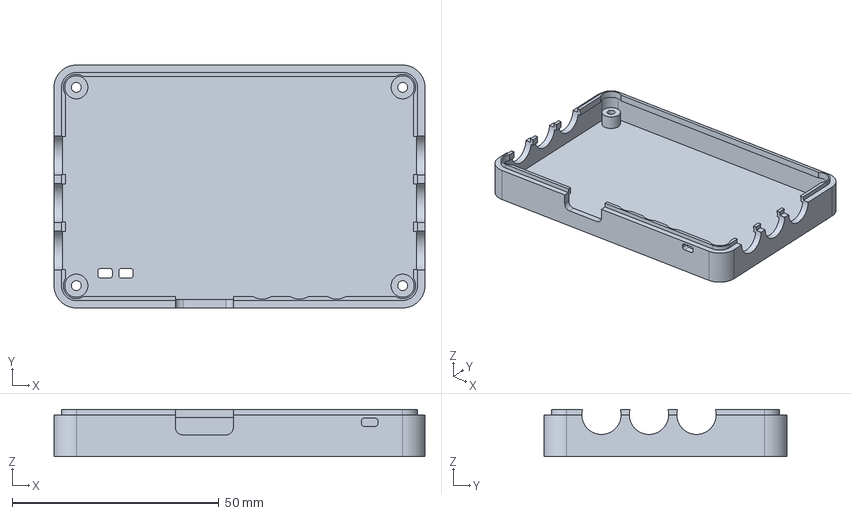
[picture p25: CAD file, 2026-10-05]
mechanical/exports/base.step
89.8 x 58.8 x 11.4 mm
