Bongorian/chiptune-usb-cv/mechanical/exports/button_cap.step

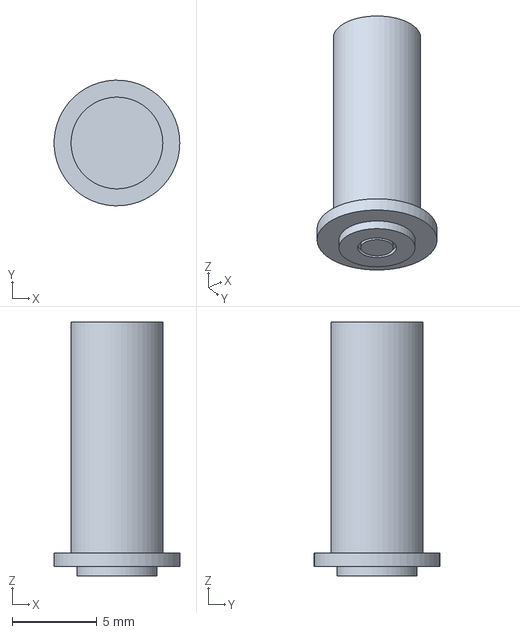
[picture p26: CAD file, 2026-10-05]
mechanical/exports/button_cap.step
7.39 x 7.40 x 14.9 mm
