Bongorian/chiptune-usb-cv/mechanical/exports/lid.step

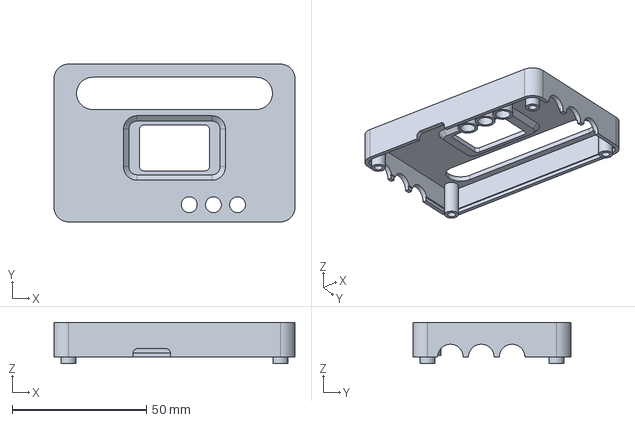
[picture p27: CAD file, 2026-10-05]
mechanical/exports/lid.step
89.8 x 58.8 x 15.4 mm
