Bongorian/chiptune-usb-cv/(list of files, cad)

Other CAD files:
mechanical/exports/base.stl
mechanical/exports/button_cap.stl
mechanical/exports/enclosure_preview.blend
mechanical/exports/fit_coupon.stl
mechanical/exports/lid.stl
