Bongorian/chiptune-usb-cv/firmware/CHARACTER_GUIDE.md

# v0.10 音色ガイド

旧16構造・旧PC/ch割当は廃止しました。現在の音作りは[構成可能なPatch](SOUND_DESIGN.md)、受信チャンネルと演奏モードは[README](README.md)、クロック効果は[SN CLOCK](SN_CLOCK.md)を参照してください。工場23音色はWave Labと本体のFACTORY一覧で同じ順序です。Program Change 0–15はUSER Patch 1–16を読み込みます。
