Bongorian/chiptune-usb-cv/firmware/dist/v0.10.0-tests.txt

Test project build/v10-tests
    Start 1: synth_tests
1/8 Test #1: synth_tests ......................   Passed    0.38 sec
    Start 2: storage_tests
2/8 Test #2: storage_tests ....................   Passed    0.27 sec
    Start 3: bus_tests
3/8 Test #3: bus_tests ........................   Passed    0.25 sec
    Start 4: protocol_tests
4/8 Test #4: protocol_tests ...................   Passed    0.26 sec
    Start 5: ui_tests
5/8 Test #5: ui_tests .........................   Passed    0.58 sec
    Start 6: sequence_tests
6/8 Test #6: sequence_tests ...................   Passed    0.26 sec
    Start 7: midi_tests
7/8 Test #7: midi_tests .......................   Passed    0.32 sec
    Start 8: display_tests
8/8 Test #8: display_tests ....................   Passed    0.26 sec

100% tests passed, 0 tests failed out of 8

Total Test time (real) =   2.59 sec

Release host:
Test project build/v10-release-host
    Start 1: synth_tests
1/8 Test #1: synth_tests ......................   Passed    0.21 sec
    Start 2: storage_tests
2/8 Test #2: storage_tests ....................   Passed    0.22 sec
    Start 3: bus_tests
3/8 Test #3: bus_tests ........................   Passed    0.21 sec
    Start 4: protocol_tests
4/8 Test #4: protocol_tests ...................   Passed    0.21 sec
    Start 5: ui_tests
5/8 Test #5: ui_tests .........................   Passed    0.24 sec
    Start 6: sequence_tests
6/8 Test #6: sequence_tests ...................   Passed    0.21 sec
    Start 7: midi_tests
7/8 Test #7: midi_tests .......................   Passed    0.21 sec
    Start 8: display_tests
8/8 Test #8: display_tests ....................   Passed    0.21 sec

100% tests passed, 0 tests failed out of 8

Total Test time (real) =   1.74 sec

Node:
✔ all compositional factory patches validate (0.700125ms)
✔ MIDI10 defaults have independent direct tracks (0.23025ms)
✔ wire schema and checksum reject incompatible versions (14.628208ms)
✔ real C Track roundtrip including signed fields and MIDI ch16 (15.078583ms)
✔ mutations before handshake and schema mismatch cannot change C state (14.114ms)
✔ sequence and CV signed endpoints roundtrip through firmware (14.060917ms)
✔ resource errors preserve prior voices and explain alternatives (13.811917ms)
✔ JSON schema is explicit and imported state is isolated (0.351416ms)
✔ capabilities and morph topology reflect real chips (0.259292ms)
✔ global tempo 240 BPM and Gate2 roundtrip without 7-bit truncation (28.130417ms)
✔ POLY focus disables only the same chip and returns assigned poly voices (14.242834ms)
✔ structure editing normalizes incompatible layers and unused noise controls (0.209666ms)
✔ C and Web agree on wave classification and capability masks for every factory (0.1115ms)
✔ C and Web construct the same chip-specific waveforms without new stored fields (0.391417ms)
✔ musical controls exclude unsupported or ineffective chip parameters (0.247959ms)
ℹ tests 15
ℹ suites 0
ℹ pass 15
ℹ fail 0
ℹ cancelled 0
ℹ skipped 0
ℹ todo 0
ℹ duration_ms 166.489958

PASS browser: offline editing/export, protocol-2 real-C sync, resource rejection, DIRECT/POLY, PAN, morph, sequence/clock/CV, independent patch save, LIVE coalescing, old-version write lock, chip-specific wave controls and Pulse/Tone3 reservations, mobile layout
