Bongorian/chiptune-usb-cv/hardware/Chiptune_USB_CV.kicad_pcb

## KiCad design hardware/Chiptune_USB_CV.kicad_pcb (2026-10-05)

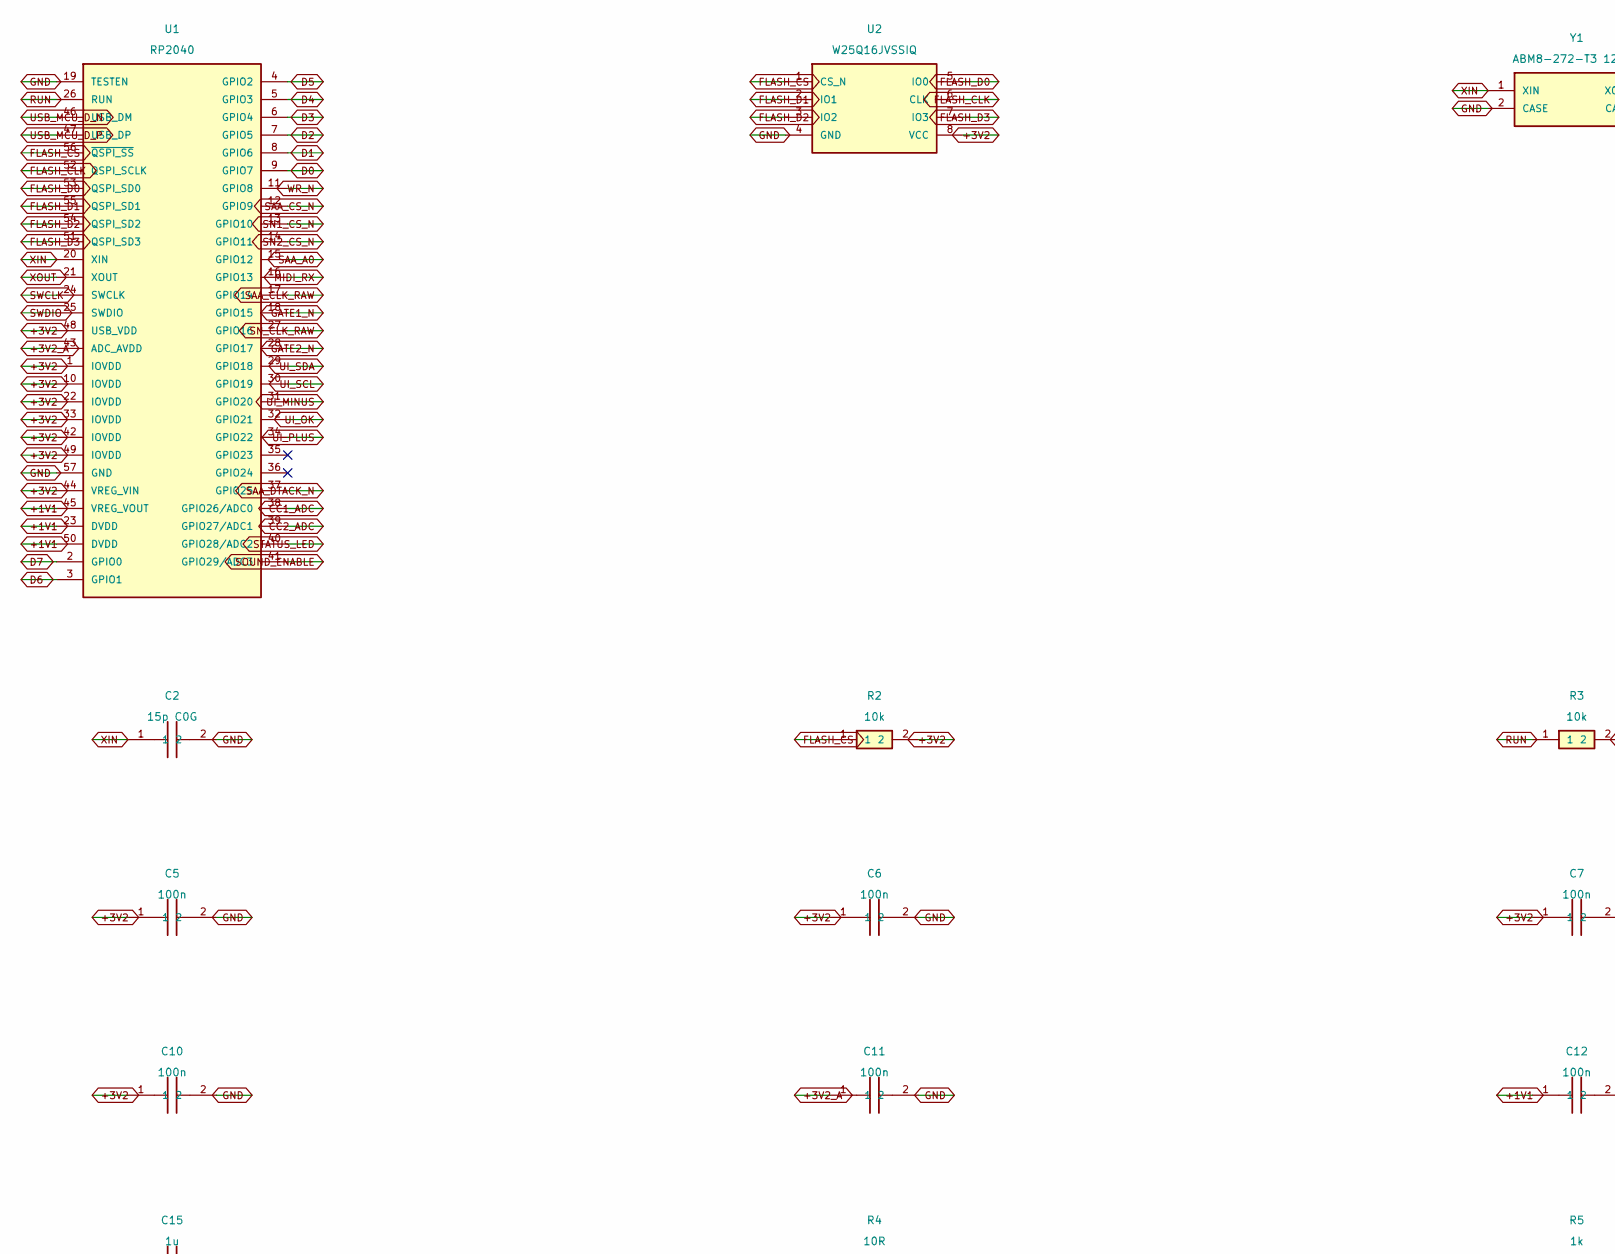
[picture p33: schematic 01.kicad_sch, MCU and programming, part in row 1, column 1]

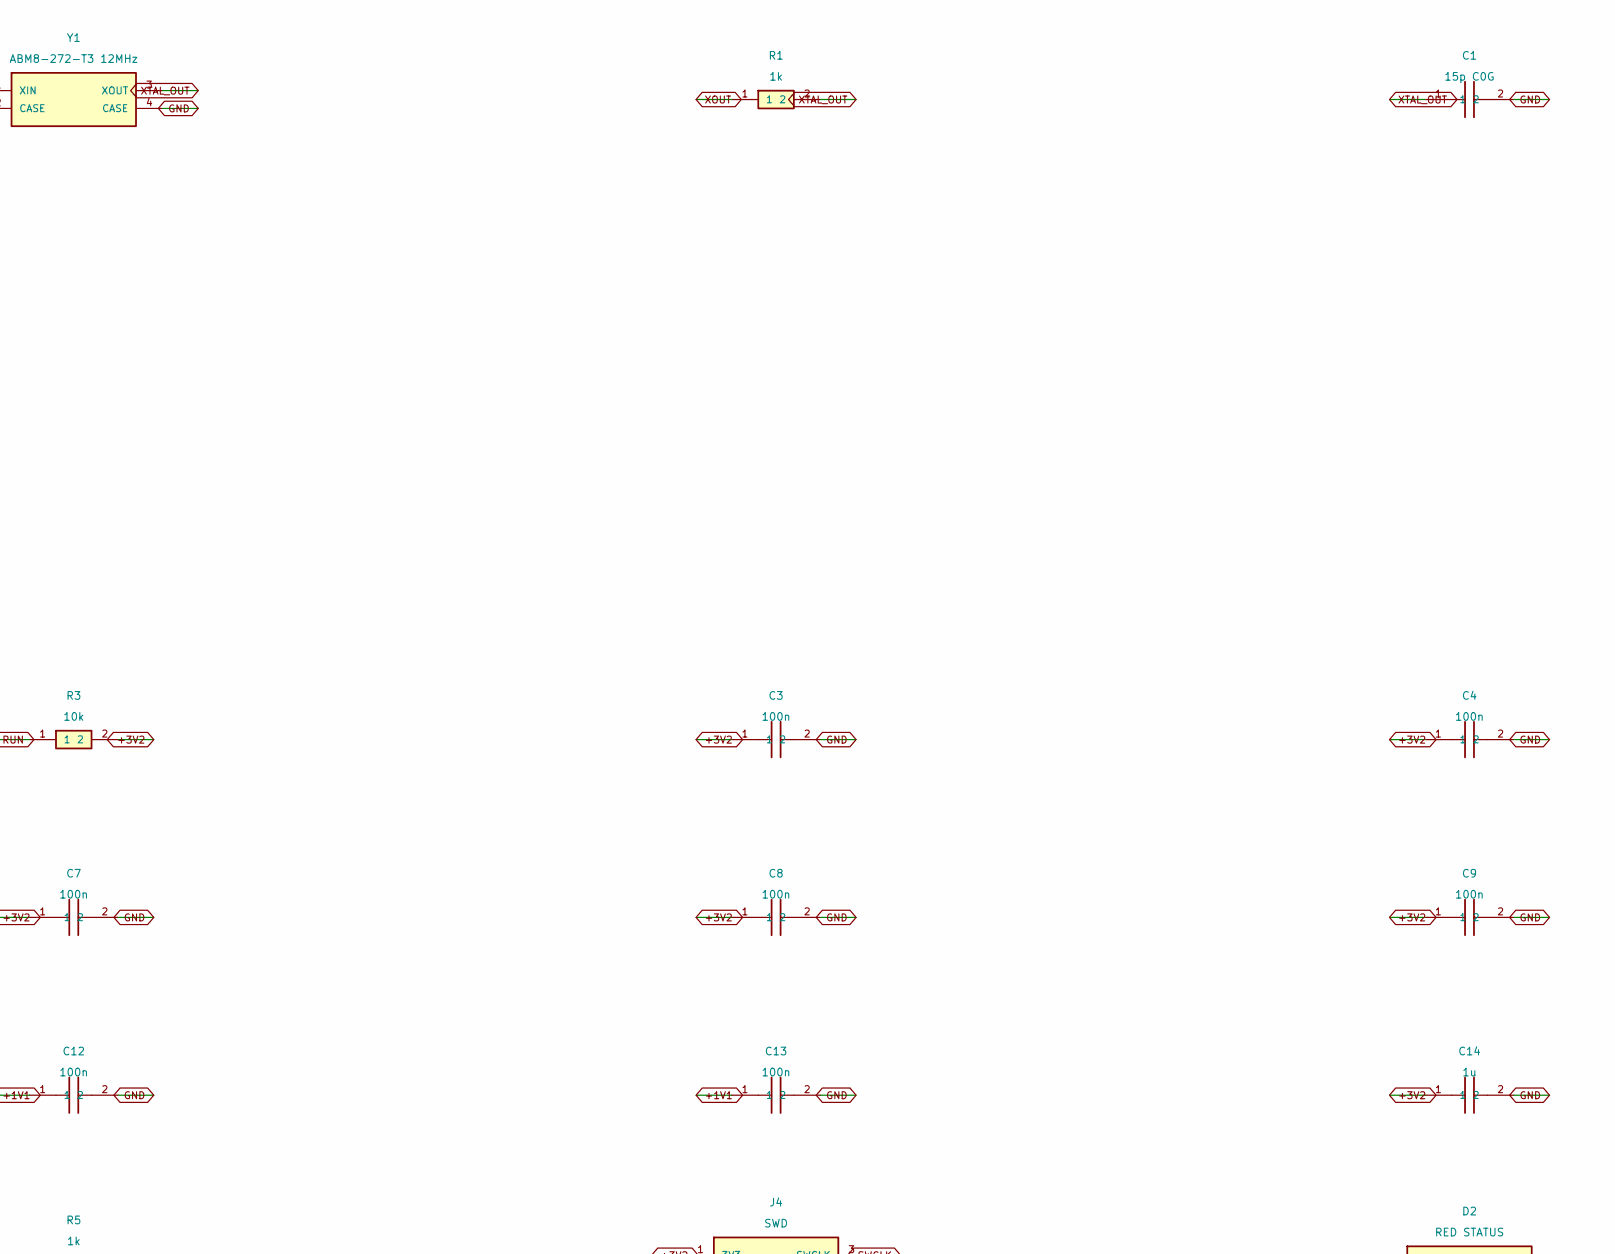
[picture p34: schematic 01.kicad_sch, MCU and programming, part in row 1, column 2]

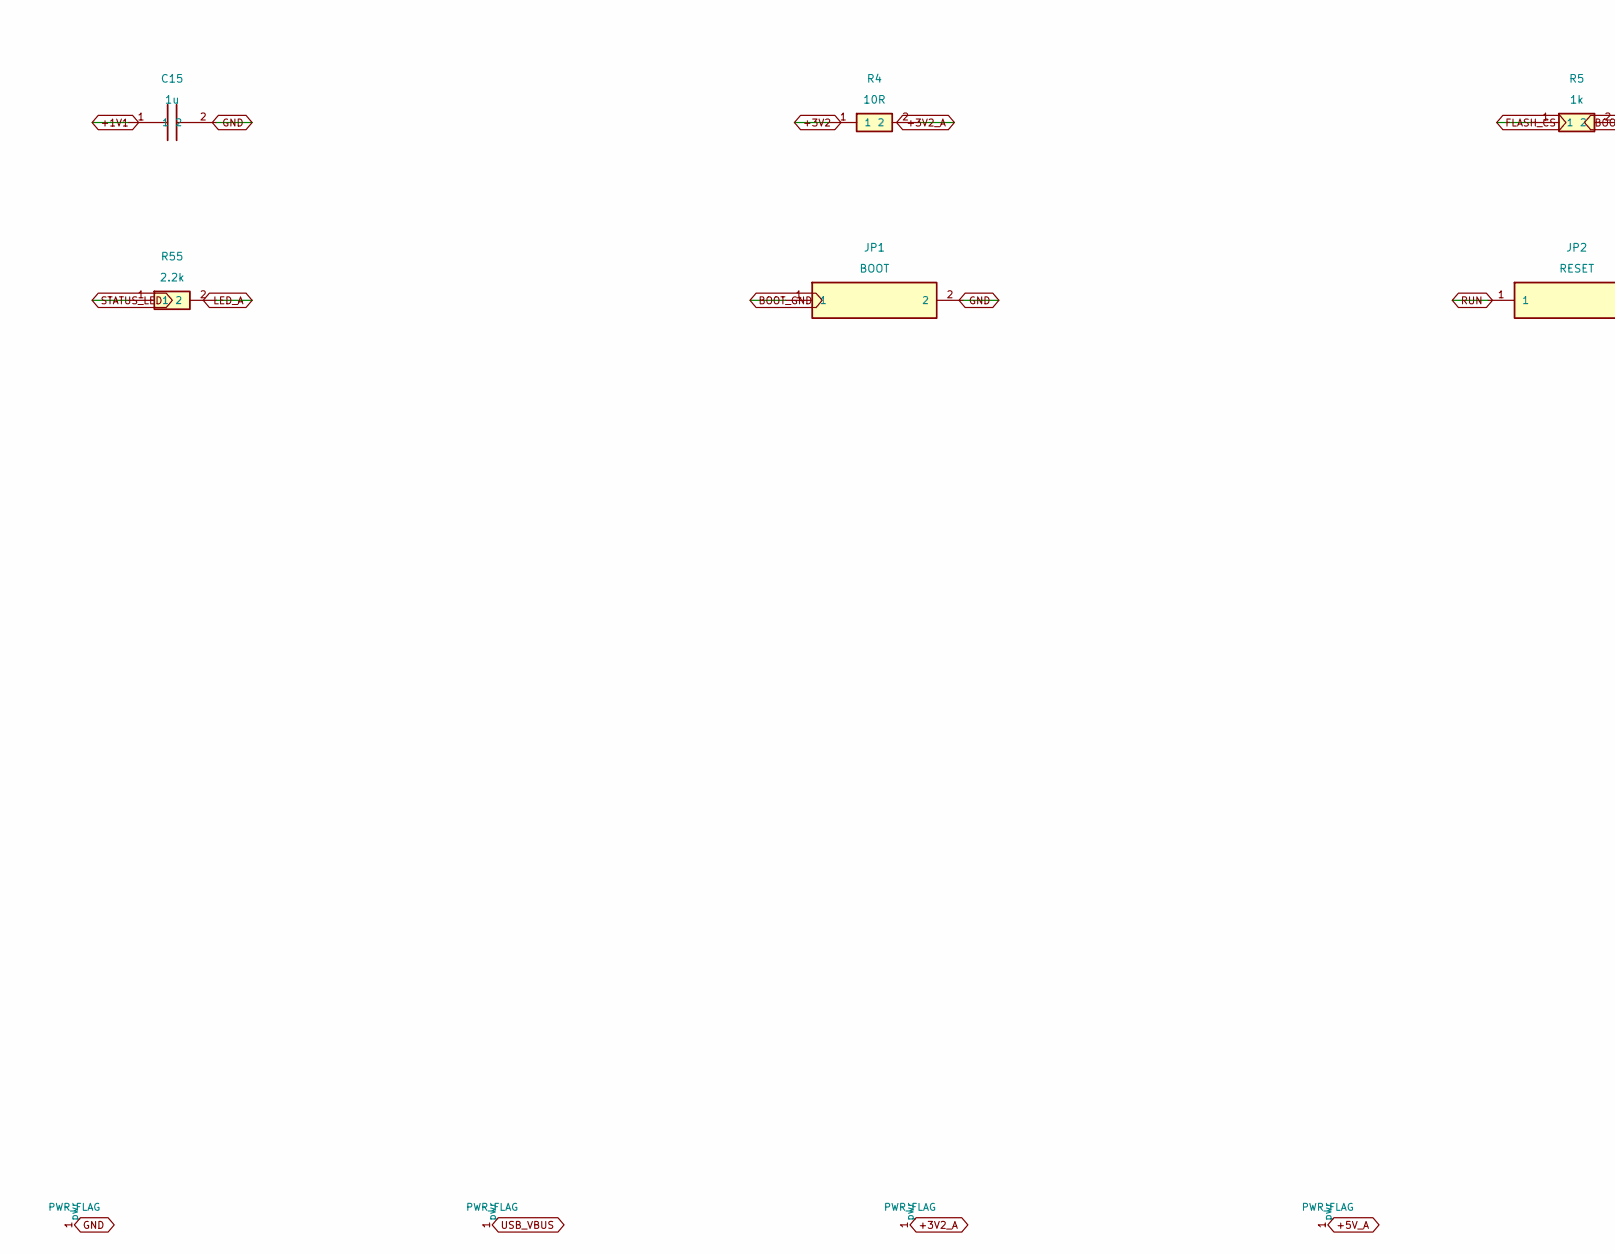
[picture p35: schematic 01.kicad_sch, MCU and programming, part in row 2, column 1]

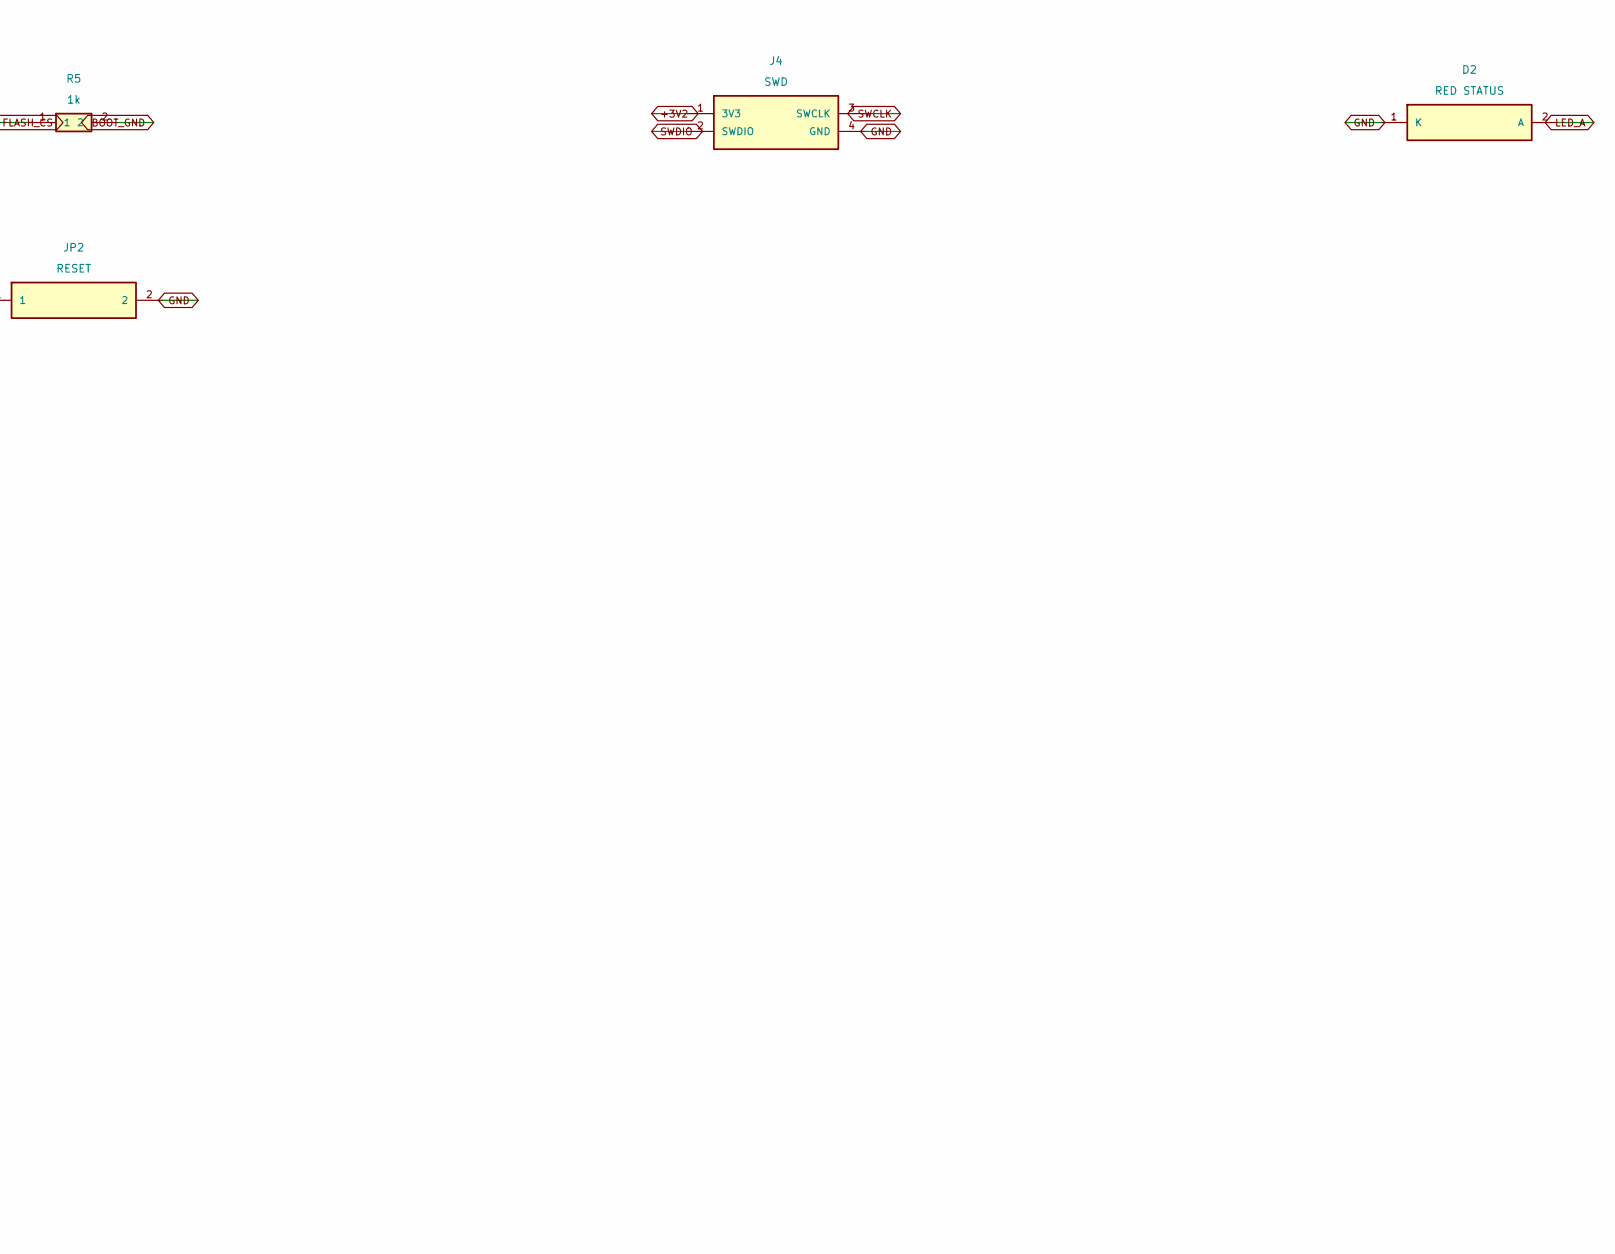
[picture p36: schematic 01.kicad_sch, MCU and programming, part in row 2, column 2]

Parts:
C1: 15p C0G; Board_C1; LCSC C1644
C2: 15p C0G; Board_C2; LCSC C1644
C3: 100n; Board_C3; LCSC C14663
C4: 100n; Board_C4; LCSC C14663
C5: 100n; Board_C5; LCSC C14663
C6: 100n; Board_C6; LCSC C14663
C7: 100n; Board_C7; LCSC C14663
C8: 100n; Board_C8; LCSC C14663
C9: 100n; Board_C9; LCSC C14663
C10: 100n; Board_C10; LCSC C14663
C11: 100n; Board_C11; LCSC C14663
C12: 100n; Board_C12; LCSC C14663
C13: 100n; Board_C13; LCSC C14663
C14: 1u; Board_C14; LCSC C15849
C15: 1u; Board_C15; LCSC C15849
D2: RED STATUS; Board_D2; LCSC C2286
J4: SWD; Board_J4
JP1: BOOT; Board_JP1
JP2: RESET; Board_JP2
R1: 1k; Board_R1; LCSC C21190
R2: 10k; Board_R2; LCSC C25804
R3: 10k; Board_R3; LCSC C25804
R4: 10R; Board_R4; LCSC C22859
R5: 1k; Board_R5; LCSC C21190
R55: 2.2k; Board_R55; LCSC C4190
U1: RP2040; Board_U1; LCSC C2040
U2: W25Q16JVSSIQ; Board_U2; LCSC C131025
Y1: ABM8-272-T3 12MHz; Board_Y1; LCSC C20625731

Connections:
+1V1: C12.1, C13.1, C15.1, U1.23 (DVDD), U1.45 (VREG_VOUT), U1.50 (DVDD)
+3V2: C3.1, C4.1, C5.1, C6.1, C7.1, C8.1, C9.1, C10.1, C14.1, J4.1 (3V3), R2.2, R3.2, R4.1, U1.1 (IOVDD), U1.10 (IOVDD), U1.22 (IOVDD), U1.33 (IOVDD), U1.42 (IOVDD), U1.44 (VREG_VIN), U1.48 (USB_VDD), U1.49 (IOVDD), U2.8 (VCC); also elsewhere on the board
+3V2_A: C11.1, R4.2, U1.43 (ADC_AVDD)
BOOT_GND: JP1.1, R5.2
CC1_ADC: U1.38 (GPIO26/ADC0); also elsewhere on the board
CC2_ADC: U1.39 (GPIO27/ADC1); also elsewhere on the board
D0: U1.9 (GPIO7); also elsewhere on the board
D1: U1.8 (GPIO6); also elsewhere on the board
D2: U1.7 (GPIO5); also elsewhere on the board
D3: U1.6 (GPIO4); also elsewhere on the board
D4: U1.5 (GPIO3); also elsewhere on the board
D5: U1.4 (GPIO2); also elsewhere on the board
D6: U1.3 (GPIO1); also elsewhere on the board
D7: U1.2 (GPIO0); also elsewhere on the board
FLASH_CLK: U1.52 (QSPI_SCLK), U2.6 (CLK)
FLASH_CS: R2.1, R5.1, U1.56 (~QSPI_SS), U2.1 (CS_N)
FLASH_D0: U1.53 (QSPI_SD0), U2.5 (IO0)
FLASH_D1: U1.55 (QSPI_SD1), U2.2 (IO1)
FLASH_D2: U1.54 (QSPI_SD2), U2.3 (IO2)
FLASH_D3: U1.51 (QSPI_SD3), U2.7 (IO3)
GATE1_N: U1.18 (GPIO15); also elsewhere on the board
GATE2_N: U1.28 (GPIO17); also elsewhere on the board
GND: C1.2, C2.2, C3.2, C4.2, C5.2, C6.2, C7.2, C8.2, C9.2, C10.2, C11.2, C12.2, C13.2, C14.2, C15.2, D2.1 (K), J4.4 (GND), JP1.2, JP2.2, U1.19 (TESTEN), U1.57 (GND), U2.4 (GND), Y1.2 (CASE), Y1.4 (CASE); also elsewhere on the board
LED_A: D2.2 (A), R55.2
MIDI_RX: U1.16 (GPIO13); also elsewhere on the board
RUN: JP2.1, R3.1, U1.26 (RUN)
SAA_A0: U1.15 (GPIO12); also elsewhere on the board
SAA_CLK_RAW: U1.17 (GPIO14); also elsewhere on the board
SAA_CS_N: U1.12 (GPIO9); also elsewhere on the board
SAA_DTACK_N: U1.37 (GPIO25); also elsewhere on the board
SN1_CS_N: U1.13 (GPIO10); also elsewhere on the board
SN2_CS_N: U1.14 (GPIO11); also elsewhere on the board
SN_CLK_RAW: U1.27 (GPIO16); also elsewhere on the board
SOUND_ENABLE: U1.41 (GPIO29/ADC3); also elsewhere on the board
STATUS_LED: R55.1, U1.40 (GPIO28/ADC2)
SWCLK: J4.3 (SWCLK), U1.24 (SWCLK)
SWDIO: J4.2 (SWDIO), U1.25 (SWDIO)
UI_MINUS: U1.31 (GPIO20); also elsewhere on the board
UI_OK: U1.32 (GPIO21); also elsewhere on the board
UI_PLUS: U1.34 (GPIO22); also elsewhere on the board
UI_SCL: U1.30 (GPIO19); also elsewhere on the board
UI_SDA: U1.29 (GPIO18); also elsewhere on the board
USB_MCU_D_N: U1.46 (USB_DM); also elsewhere on the board
USB_MCU_D_P: U1.47 (USB_DP); also elsewhere on the board
WR_N: U1.11 (GPIO8); also elsewhere on the board
XIN: C2.1, U1.20 (XIN), Y1.1 (XIN)
XOUT: R1.1, U1.21 (XOUT)
XTAL_OUT: C1.1, R1.2, Y1.3 (XOUT)

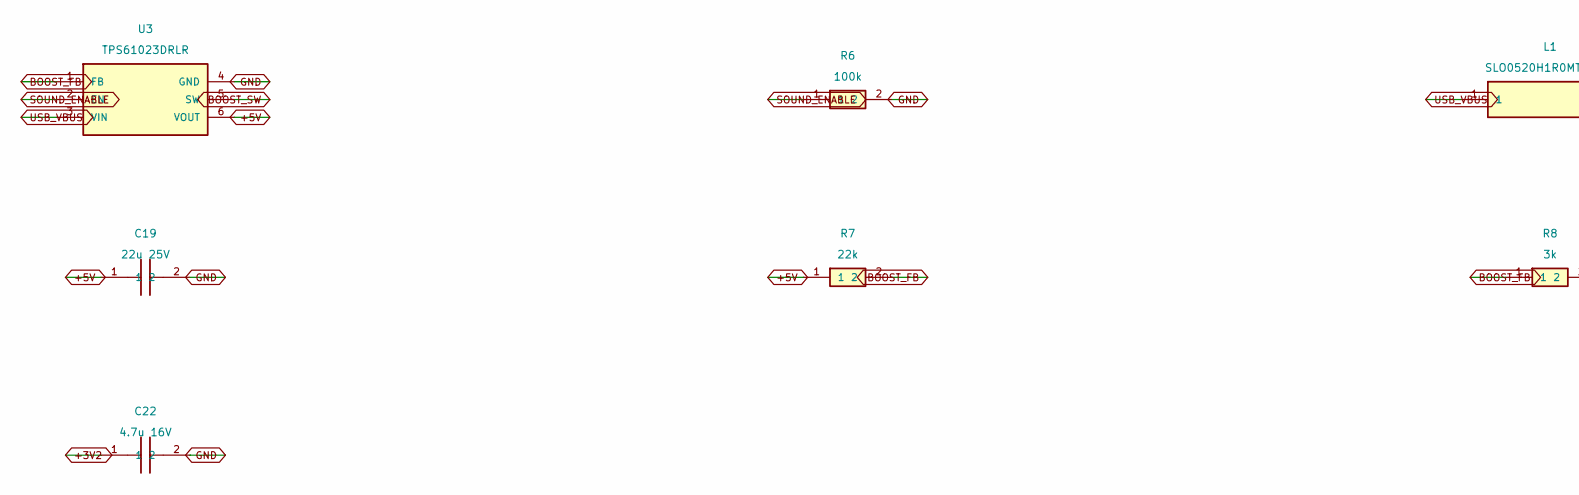
[picture p37: schematic 02.kicad_sch, USB power and sound supply, part in row 1, column 1]

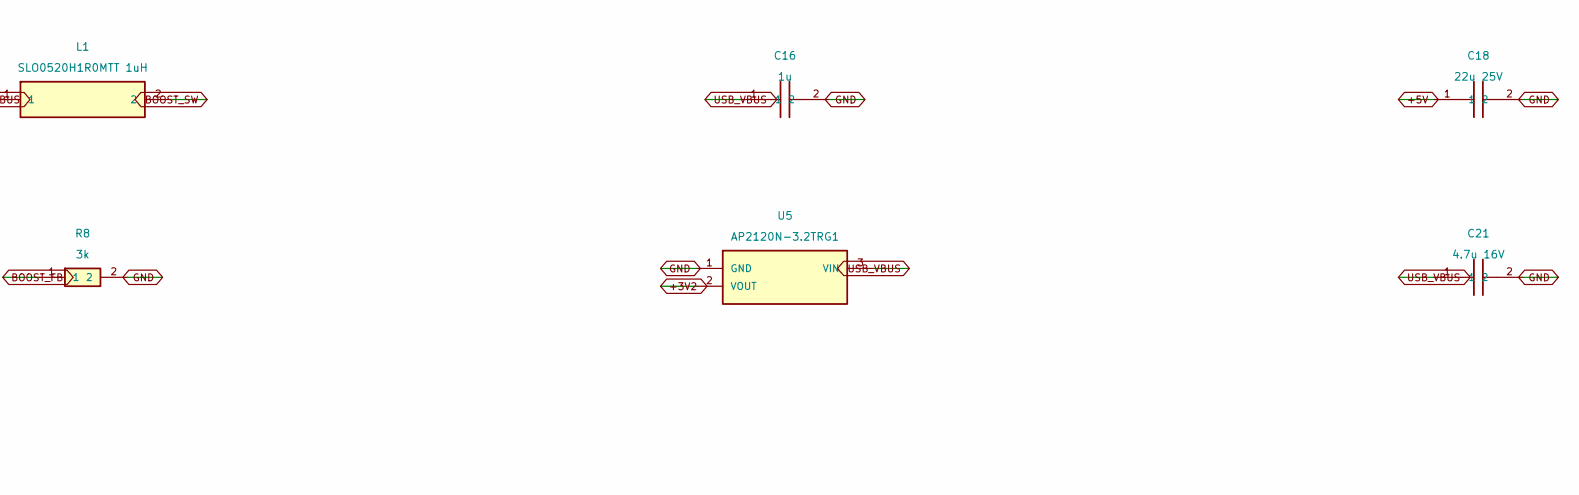
[picture p38: schematic 02.kicad_sch, USB power and sound supply, part in row 1, column 2]

Parts:
C16: 1u; Board_C16; LCSC C15849
C18: 22u 25V; Board_C18; LCSC C45783
C19: 22u 25V; Board_C19; LCSC C45783
C21: 4.7u 16V; Board_C21; LCSC C19666
C22: 4.7u 16V; Board_C22; LCSC C19666
L1: SLO0520H1R0MTT 1uH; Board_L1; LCSC C325980
R6: 100k; Board_R6; LCSC C25803
R7: 22k; Board_R7; LCSC C31850
R8: 3k; Board_R8; LCSC C4211
U3: TPS61023DRLR; Board_U3; LCSC C919459
U5: AP2120N-3.2TRG1; Board_U5; LCSC C6500828

Connections:
+3V2: C22.1, U5.2 (VOUT); also elsewhere on the board
+5V: C18.1, C19.1, R7.1, U3.6 (VOUT); also elsewhere on the board
BOOST_FB: R7.2, R8.1, U3.1 (FB)
BOOST_SW: L1.2, U3.5 (SW)
GND: C16.2, C18.2, C19.2, C21.2, C22.2, R6.2, R8.2, U3.4 (GND), U5.1 (GND); also elsewhere on the board
SOUND_ENABLE: R6.1, U3.2 (EN); also elsewhere on the board
USB_VBUS: C16.1, C21.1, L1.1, U3.3 (VIN), U5.3 (VIN); also elsewhere on the board

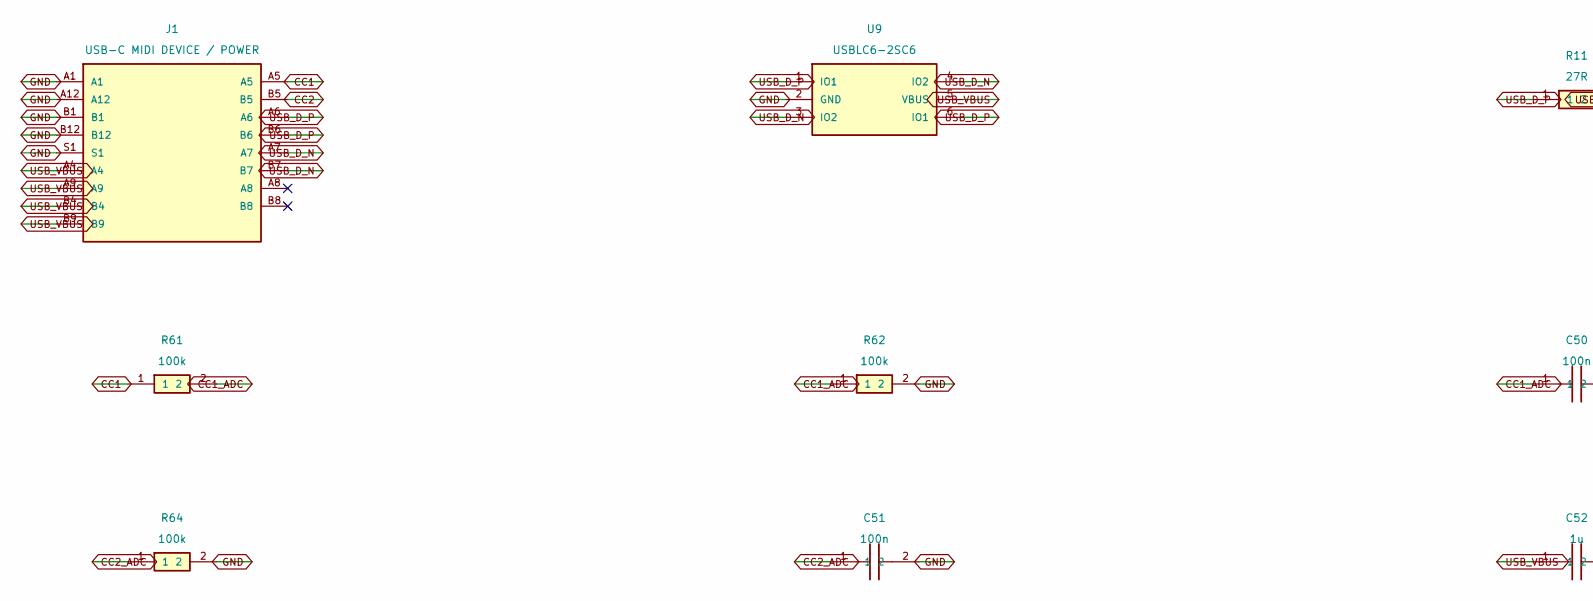
[picture p39: schematic 03.kicad_sch, USB-C device, part in row 1, column 1]

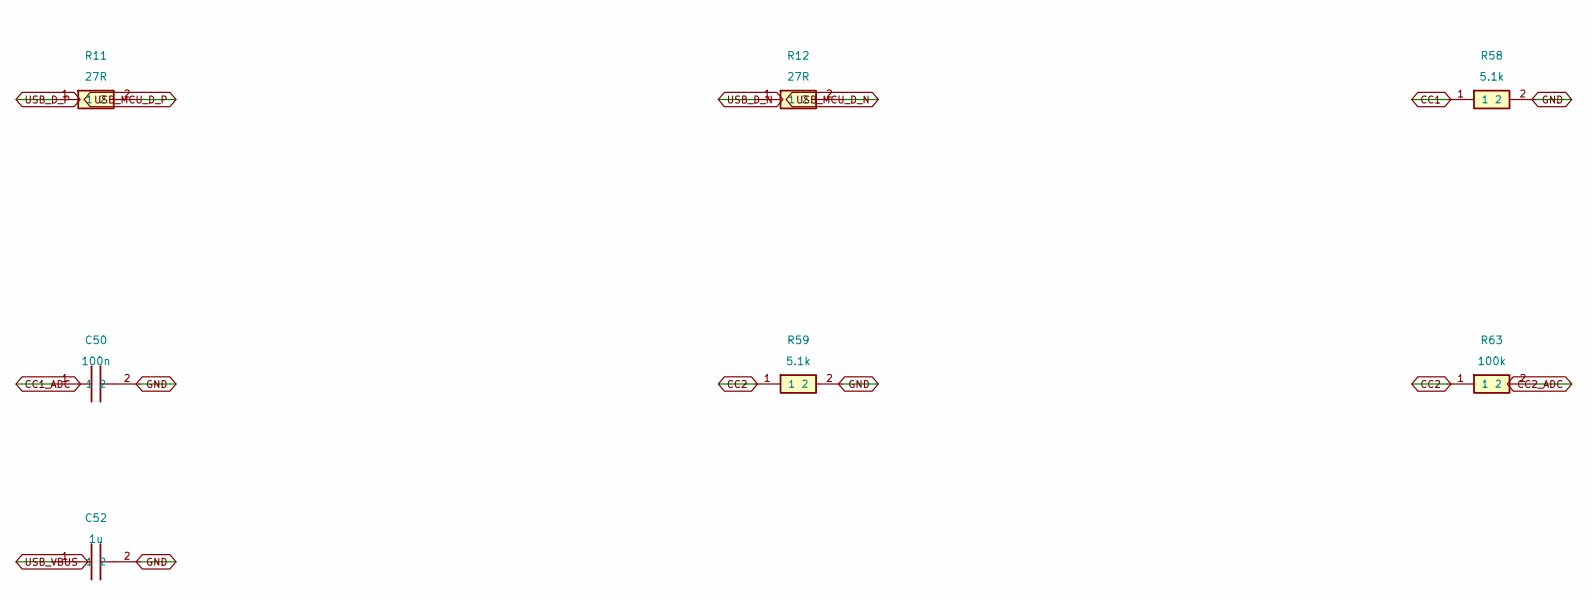
[picture p40: schematic 03.kicad_sch, USB-C device, part in row 1, column 2]

Parts:
C50: 100n; Board_C50; LCSC C14663
C51: 100n; Board_C51; LCSC C14663
C52: 1u; Board_C52; LCSC C15849
J1: USB-C MIDI DEVICE / POWER; Board_J1; LCSC C165948
R11: 27R; Board_R11; LCSC C25190
R12: 27R; Board_R12; LCSC C25190
R58: 5.1k; Board_R58; LCSC C23186
R59: 5.1k; Board_R59; LCSC C23186
R61: 100k; Board_R61; LCSC C25803
R62: 100k; Board_R62; LCSC C25803
R63: 100k; Board_R63; LCSC C25803
R64: 100k; Board_R64; LCSC C25803
U9: USBLC6-2SC6; Board_U9; LCSC C7519

Connections:
CC1: J1.A5, R58.1, R61.1
CC1_ADC: C50.1, R61.2, R62.1; also elsewhere on the board
CC2: J1.B5, R59.1, R63.1
CC2_ADC: C51.1, R63.2, R64.1; also elsewhere on the board
GND: C50.2, C51.2, C52.2, J1.A1, J1.A12, J1.B1, J1.B12, J1.S1, R58.2, R59.2, R62.2, R64.2, U9.2 (GND); also elsewhere on the board
USB_D_N: J1.A7, J1.B7, R12.1, U9.3 (IO2), U9.4 (IO2)
USB_D_P: J1.A6, J1.B6, R11.1, U9.1 (IO1), U9.6 (IO1)
USB_MCU_D_N: R12.2; also elsewhere on the board
USB_MCU_D_P: R11.2; also elsewhere on the board
USB_VBUS: C52.1, J1.A4, J1.A9, J1.B4, J1.B9, U9.5 (VBUS); also elsewhere on the board

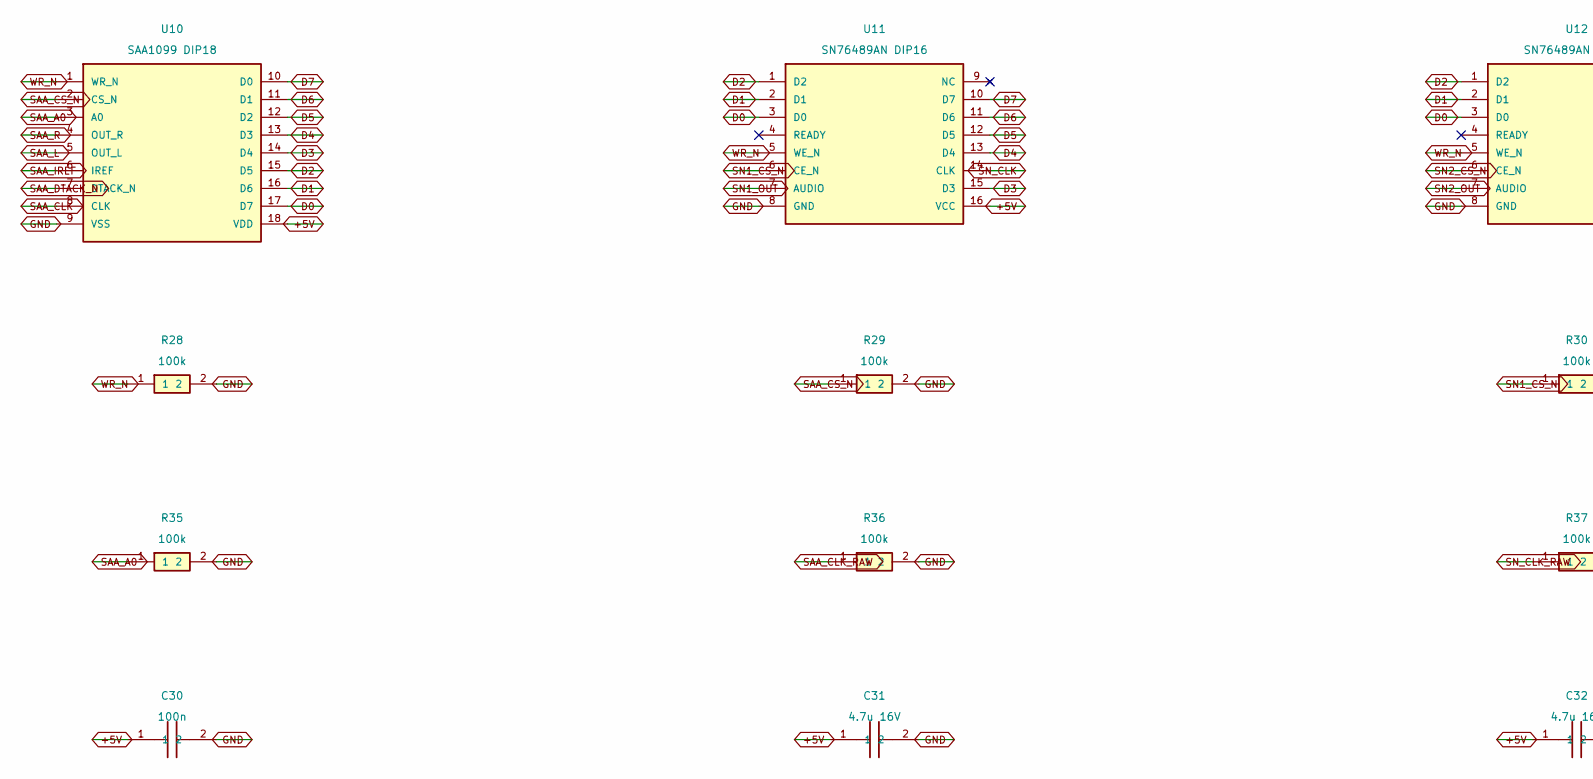
[picture p41: schematic 04.kicad_sch, Sound IC sockets, part in row 1, column 1]

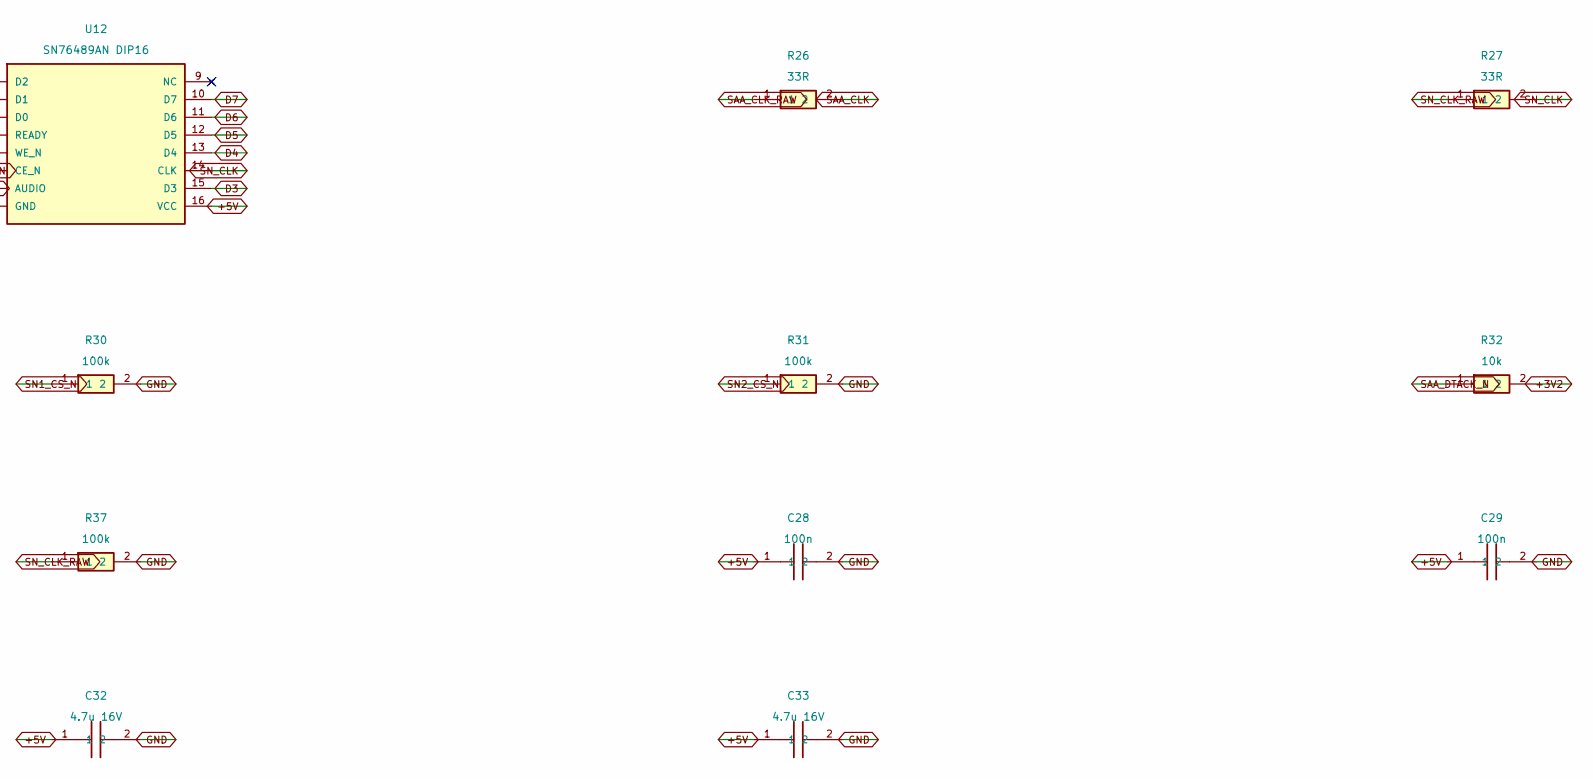
[picture p42: schematic 04.kicad_sch, Sound IC sockets, part in row 1, column 2]

Parts:
C28: 100n; Board_C28; LCSC C14663
C29: 100n; Board_C29; LCSC C14663
C30: 100n; Board_C30; LCSC C14663
C31: 4.7u 16V; Board_C31; LCSC C19666
C32: 4.7u 16V; Board_C32; LCSC C19666
C33: 4.7u 16V; Board_C33; LCSC C19666
R26: 33R; Board_R26; LCSC C23140
R27: 33R; Board_R27; LCSC C23140
R28: 100k; Board_R28; LCSC C25803
R29: 100k; Board_R29; LCSC C25803
R30: 100k; Board_R30; LCSC C25803
R31: 100k; Board_R31; LCSC C25803
R32: 10k; Board_R32; LCSC C25804
R35: 100k; Board_R35; LCSC C25803
R36: 100k; Board_R36; LCSC C25803
R37: 100k; Board_R37; LCSC C25803
U10: SAA1099 DIP18; Board_U10
U11: SN76489AN DIP16; Board_U11
U12: SN76489AN DIP16; Board_U12

Connections:
+3V2: R32.2; also elsewhere on the board
+5V: C28.1, C29.1, C30.1, C31.1, C32.1, C33.1, U10.18 (VDD), U11.16 (VCC), U12.16 (VCC); also elsewhere on the board
D0: U10.17 (D7), U11.3 (D0), U12.3 (D0); also elsewhere on the board
D1: U10.16 (D6), U11.2 (D1), U12.2 (D1); also elsewhere on the board
D2: U10.15 (D5), U11.1 (D2), U12.1 (D2); also elsewhere on the board
D3: U10.14 (D4), U11.15 (D3), U12.15 (D3); also elsewhere on the board
D4: U10.13 (D3), U11.13 (D4), U12.13 (D4); also elsewhere on the board
D5: U10.12 (D2), U11.12 (D5), U12.12 (D5); also elsewhere on the board
D6: U10.11 (D1), U11.11 (D6), U12.11 (D6); also elsewhere on the board
D7: U10.10 (D0), U11.10 (D7), U12.10 (D7); also elsewhere on the board
GND: C28.2, C29.2, C30.2, C31.2, C32.2, C33.2, R28.2, R29.2, R30.2, R31.2, R35.2, R36.2, R37.2, U10.9 (VSS), U11.8 (GND), U12.8 (GND); also elsewhere on the board
SAA_A0: R35.1, U10.3 (A0); also elsewhere on the board
SAA_CLK: R26.2, U10.8 (CLK)
SAA_CLK_RAW: R26.1, R36.1; also elsewhere on the board
SAA_CS_N: R29.1, U10.2 (CS_N); also elsewhere on the board
SAA_DTACK_N: R32.1, U10.7 (DTACK_N); also elsewhere on the board
SAA_IREF: U10.6 (IREF); also elsewhere on the board
SAA_L: U10.5 (OUT_L); also elsewhere on the board
SAA_R: U10.4 (OUT_R); also elsewhere on the board
SN1_CS_N: R30.1, U11.6 (CE_N); also elsewhere on the board
SN1_OUT: U11.7 (AUDIO); also elsewhere on the board
SN2_CS_N: R31.1, U12.6 (CE_N); also elsewhere on the board
SN2_OUT: U12.7 (AUDIO); also elsewhere on the board
SN_CLK: R27.2, U11.14 (CLK), U12.14 (CLK)
SN_CLK_RAW: R27.1, R37.1; also elsewhere on the board
WR_N: R28.1, U10.1 (WR_N), U11.5 (WE_N), U12.5 (WE_N); also elsewhere on the board

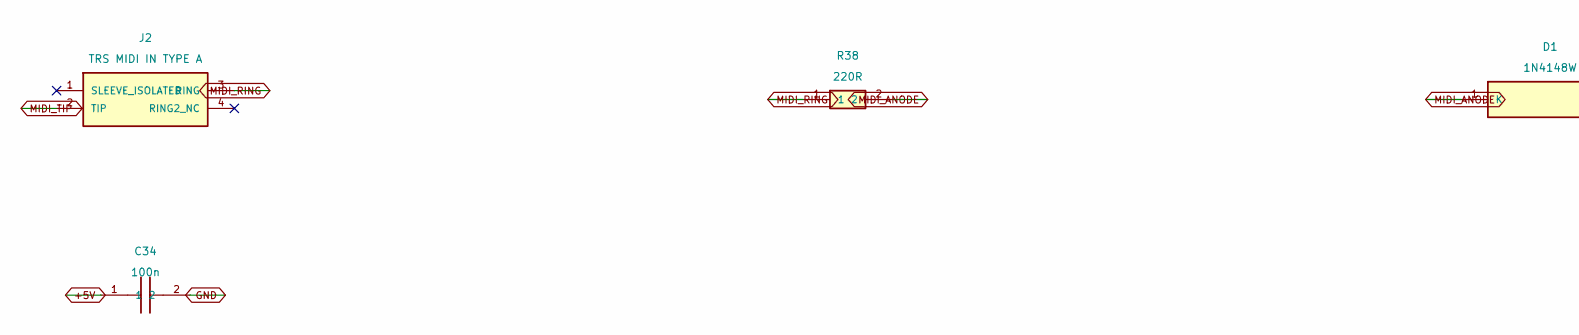
[picture p43: schematic 05.kicad_sch, Isolated MIDI input, part in row 1, column 1]

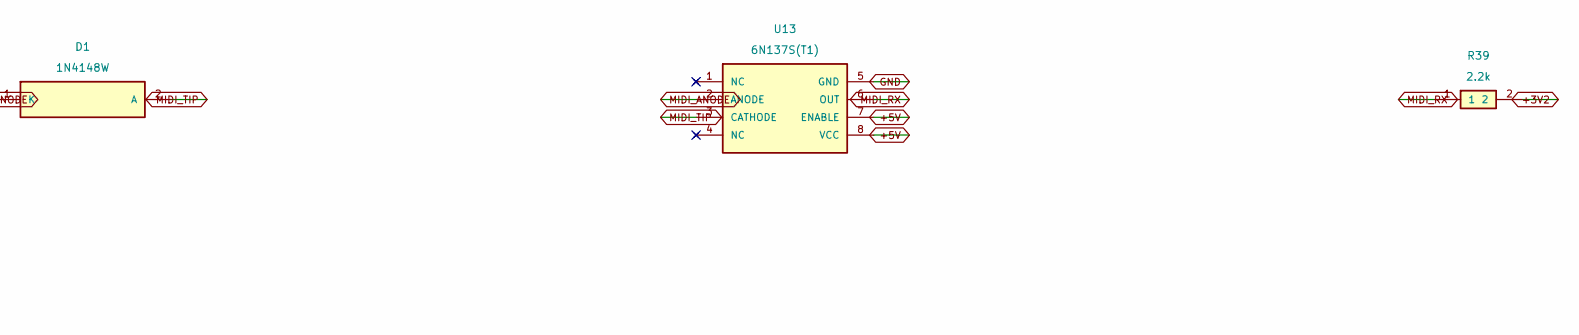
[picture p44: schematic 05.kicad_sch, Isolated MIDI input, part in row 1, column 2]

Parts:
C34: 100n; Board_C34; LCSC C14663
D1: 1N4148W; Board_D1; LCSC C81598
J2: TRS MIDI IN TYPE A; Board_J2; LCSC C95562
R38: 220R; Board_R38; LCSC C22962
R39: 2.2k; Board_R39; LCSC C4190
U13: 6N137S(T1); Board_U13; LCSC C191867

Connections:
+3V2: R39.2; also elsewhere on the board
+5V: C34.1, U13.7 (ENABLE), U13.8 (VCC); also elsewhere on the board
GND: C34.2, U13.5 (GND); also elsewhere on the board
MIDI_ANODE: D1.1 (K), R38.2, U13.2 (ANODE)
MIDI_RING: J2.3 (RING), R38.1
MIDI_RX: R39.1, U13.6 (OUT); also elsewhere on the board
MIDI_TIP: D1.2 (A), J2.2 (TIP), U13.3 (CATHODE)
