Bongorian/chiptune-usb-cv/hardware/Chiptune_USB_CV.kicad_pcb

## KiCad design hardware/Chiptune_USB_CV.kicad_pcb (continued)

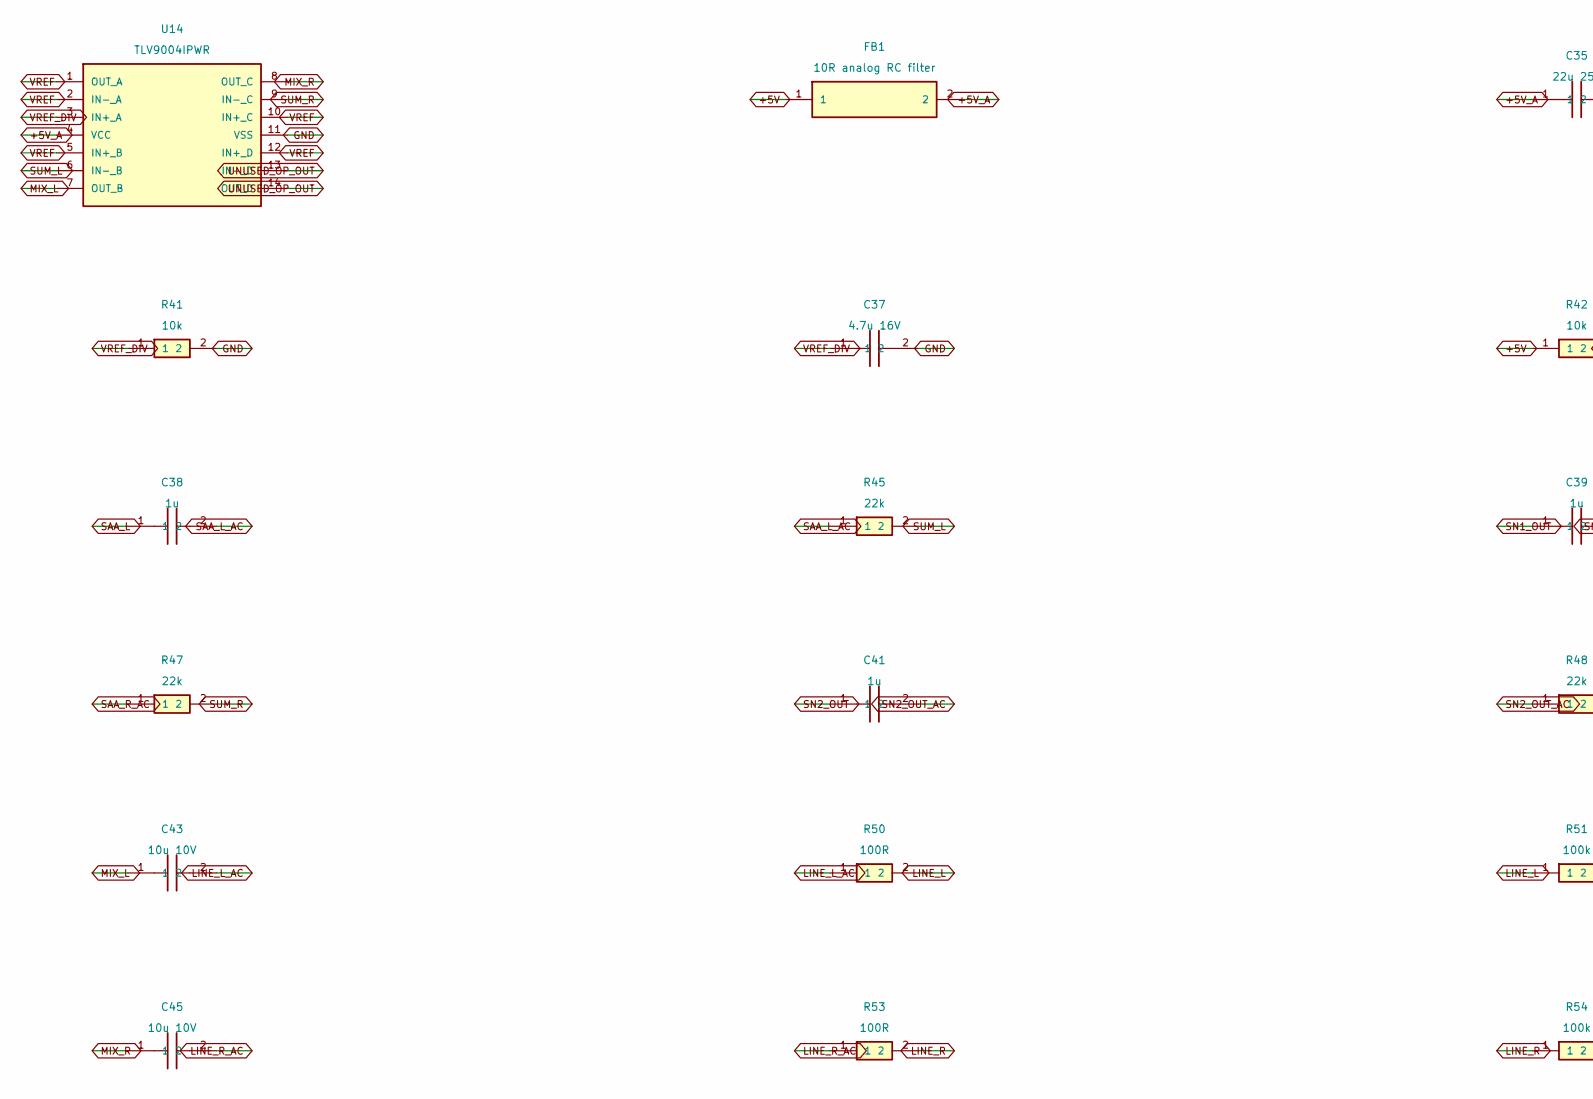
[picture p45: schematic 06.kicad_sch, Stereo line mixer, part in row 1, column 1]

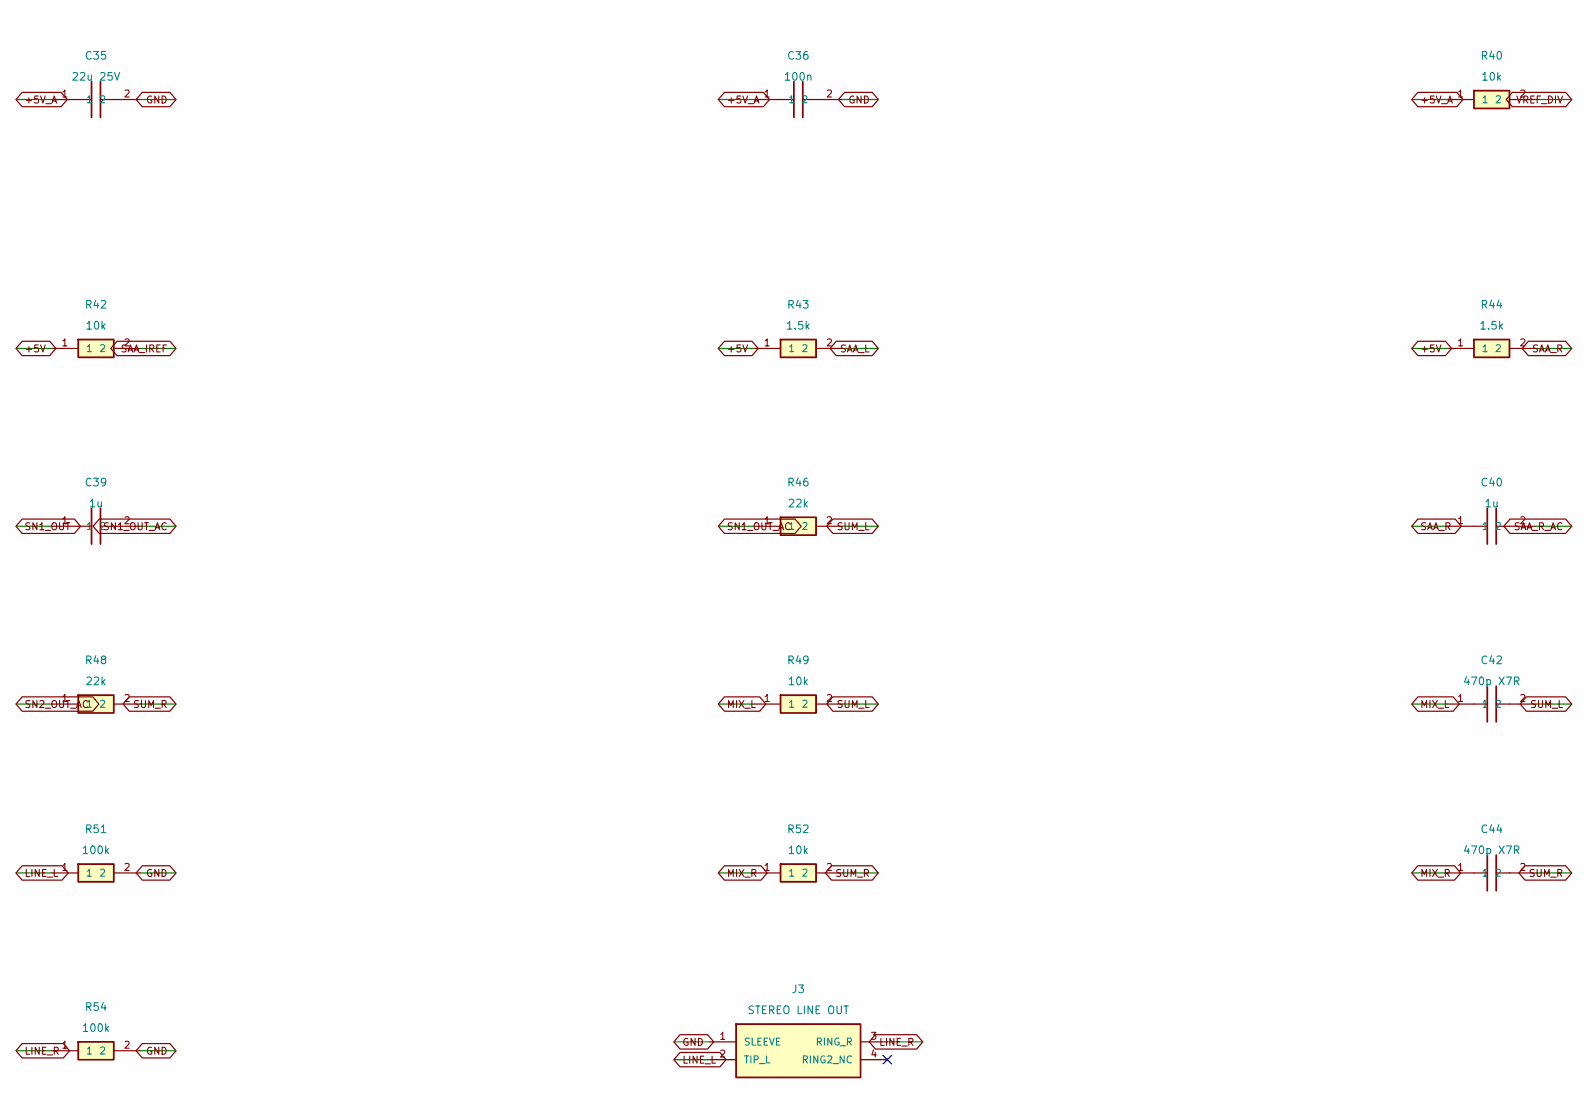
[picture p46: schematic 06.kicad_sch, Stereo line mixer, part in row 1, column 2]

Parts:
C35: 22u 25V; Board_C35; LCSC C45783
C36: 100n; Board_C36; LCSC C14663
C37: 4.7u 16V; Board_C37; LCSC C19666
C38: 1u; Board_C38; LCSC C15849
C39: 1u; Board_C39; LCSC C15849
C40: 1u; Board_C40; LCSC C15849
C41: 1u; Board_C41; LCSC C15849
C42: 470p X7R; Board_C42; LCSC C1620
C43: 10u 10V; Board_C43; LCSC C19702
C44: 470p X7R; Board_C44; LCSC C1620
C45: 10u 10V; Board_C45; LCSC C19702
FB1: 10R analog RC filter; Board_FB1; LCSC C22859
J3: STEREO LINE OUT; Board_J3; LCSC C95562
R40: 10k; Board_R40; LCSC C25804
R41: 10k; Board_R41; LCSC C25804
R42: 10k; Board_R42; LCSC C25804
R43: 1.5k; Board_R43; LCSC C22843
R44: 1.5k; Board_R44; LCSC C22843
R45: 22k; Board_R45; LCSC C31850
R46: 22k; Board_R46; LCSC C31850
R47: 22k; Board_R47; LCSC C31850
R48: 22k; Board_R48; LCSC C31850
R49: 10k; Board_R49; LCSC C25804
R50: 100R; Board_R50; LCSC C22775
R51: 100k; Board_R51; LCSC C25803
R52: 10k; Board_R52; LCSC C25804
R53: 100R; Board_R53; LCSC C22775
R54: 100k; Board_R54; LCSC C25803
U14: TLV9004IPWR; Board_U14; LCSC C2058050

Connections:
+5V: FB1.1, R42.1, R43.1, R44.1; also elsewhere on the board
+5V_A: C35.1, C36.1, FB1.2, R40.1, U14.4 (VCC)
GND: C35.2, C36.2, C37.2, J3.1 (SLEEVE), R41.2, R51.2, R54.2, U14.11 (VSS); also elsewhere on the board
LINE_L: J3.2 (TIP_L), R50.2, R51.1
LINE_L_AC: C43.2, R50.1
LINE_R: J3.3 (RING_R), R53.2, R54.1
LINE_R_AC: C45.2, R53.1
MIX_L: C42.1, C43.1, R49.1, U14.7 (OUT_B)
MIX_R: C44.1, C45.1, R52.1, U14.8 (OUT_C)
SAA_IREF: R42.2; also elsewhere on the board
SAA_L: C38.1, R43.2; also elsewhere on the board
SAA_L_AC: C38.2, R45.1
SAA_R: C40.1, R44.2; also elsewhere on the board
SAA_R_AC: C40.2, R47.1
SN1_OUT: C39.1; also elsewhere on the board
SN1_OUT_AC: C39.2, R46.1
SN2_OUT: C41.1; also elsewhere on the board
SN2_OUT_AC: C41.2, R48.1
SUM_L: C42.2, R45.2, R46.2, R49.2, U14.6 (IN-_B)
SUM_R: C44.2, R47.2, R48.2, R52.2, U14.9 (IN-_C)
UNUSED_OP_OUT: U14.13 (IN-_D), U14.14 (OUT_D)
VREF: U14.1 (OUT_A), U14.2 (IN-_A), U14.5 (IN+_B), U14.10 (IN+_C), U14.12 (IN+_D)
VREF_DIV: C37.1, R40.2, R41.1, U14.3 (IN+_A)

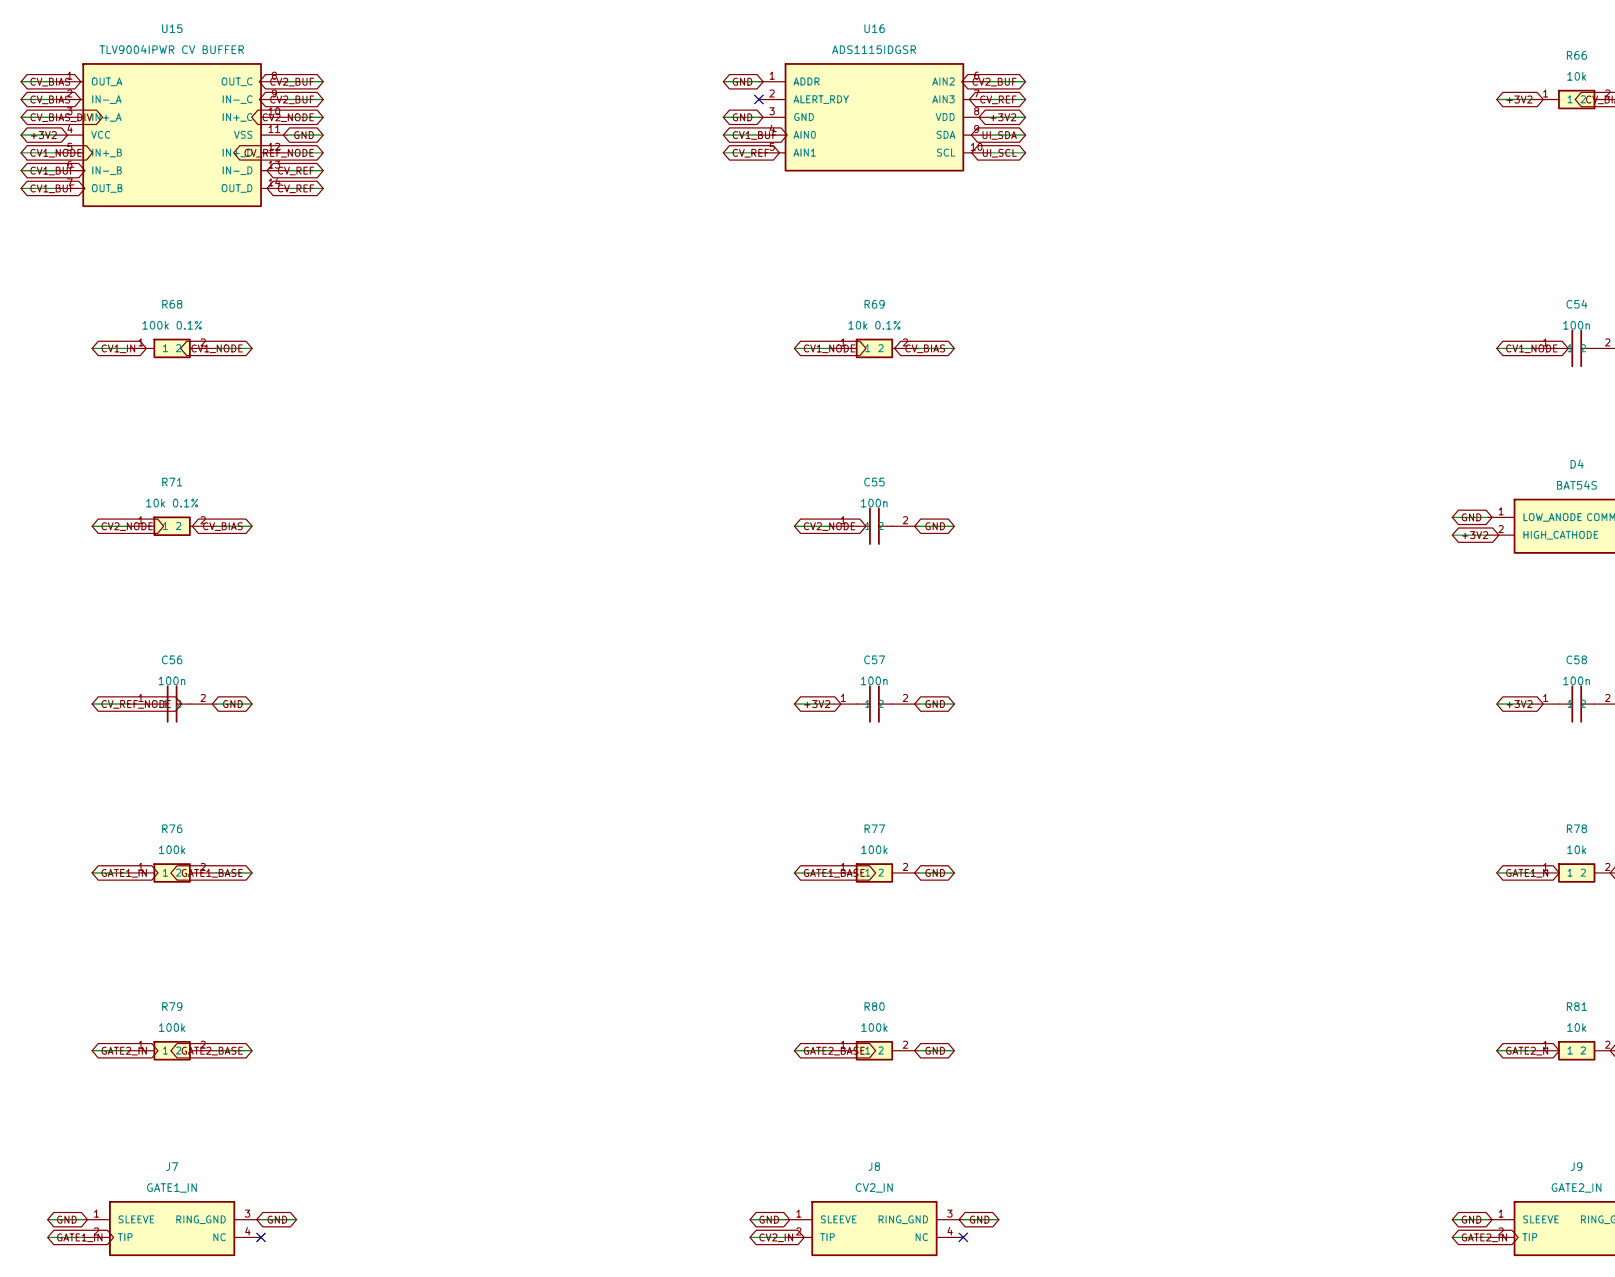
[picture p47: schematic 07.kicad_sch, CV and gate inputs, part in row 1, column 1]

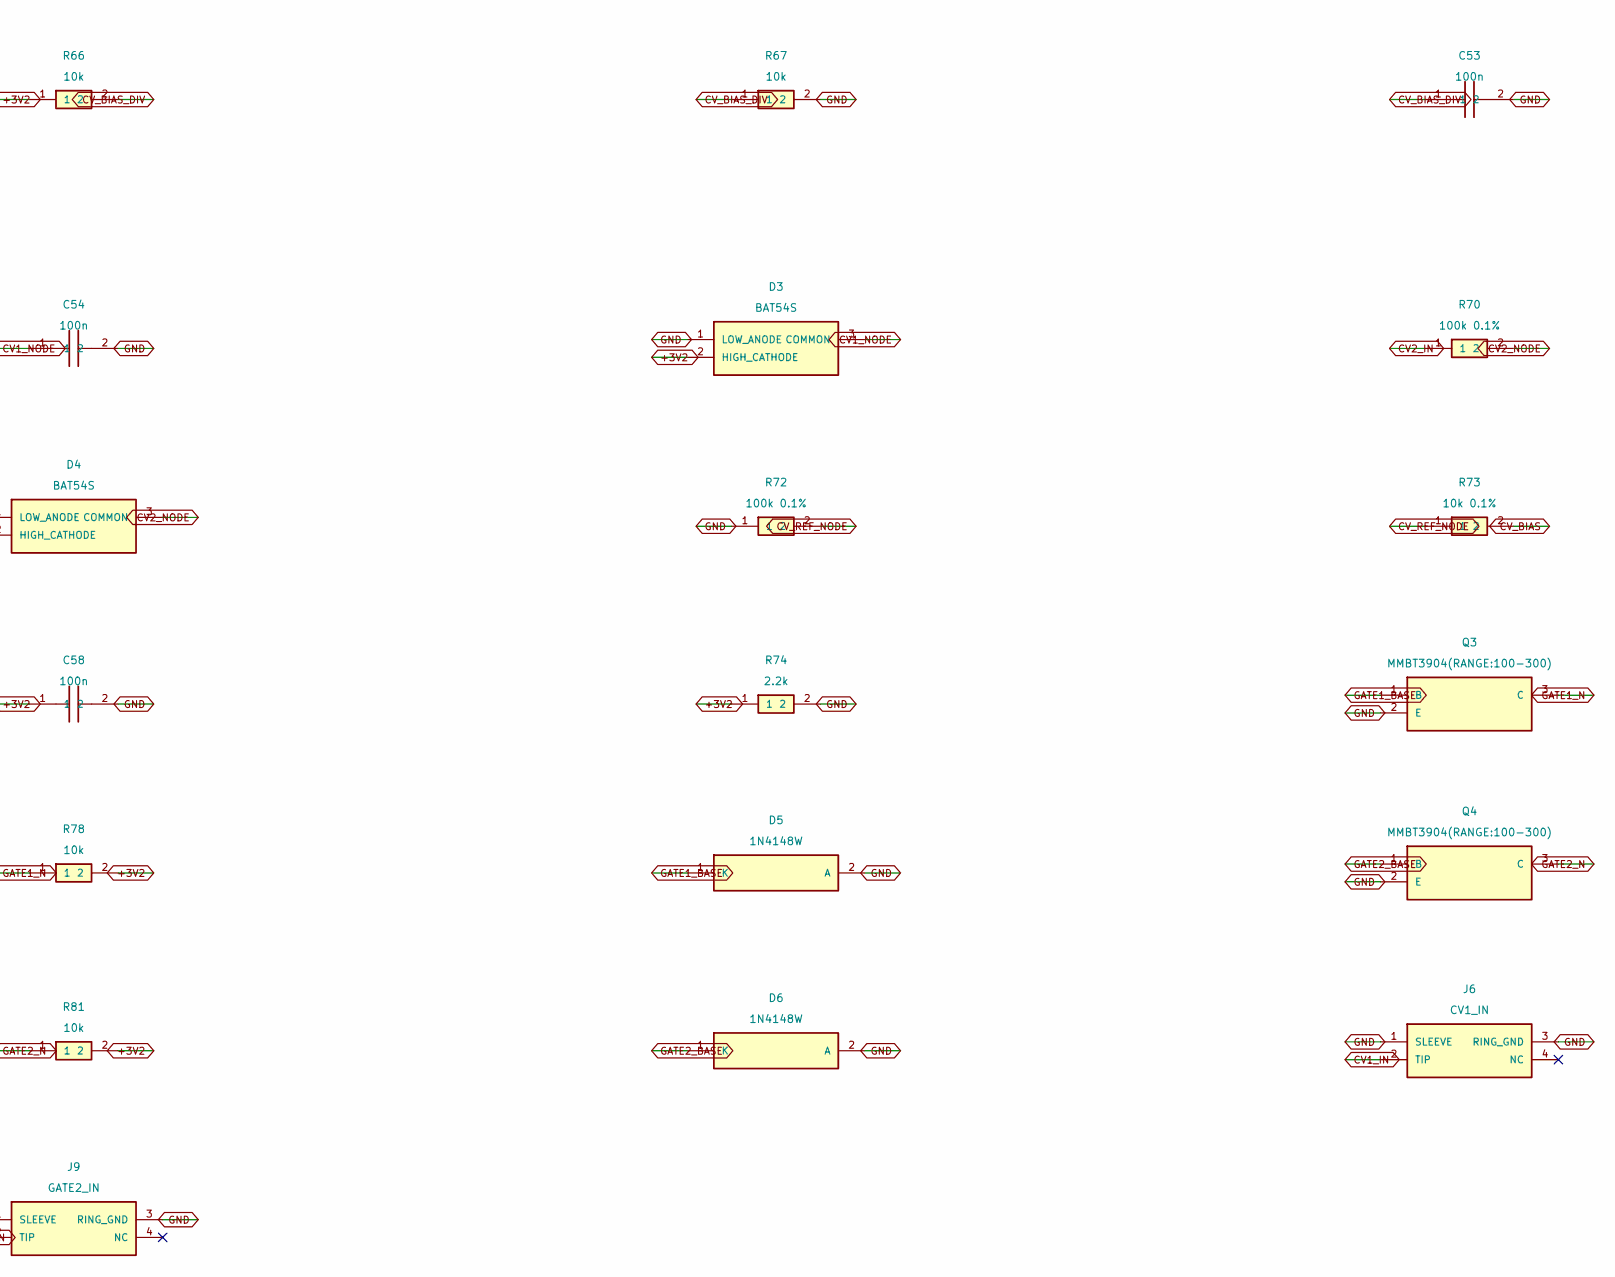
[picture p48: schematic 07.kicad_sch, CV and gate inputs, part in row 1, column 2]

Parts:
C53: 100n; Board_C53; LCSC C14663
C54: 100n; Board_C54; LCSC C14663
C55: 100n; Board_C55; LCSC C14663
C56: 100n; Board_C56; LCSC C14663
C57: 100n; Board_C57; LCSC C14663
C58: 100n; Board_C58; LCSC C14663
D3: BAT54S; Board_D3; LCSC C83935
D4: BAT54S; Board_D4; LCSC C83935
D5: 1N4148W; Board_D5; LCSC C81598
D6: 1N4148W; Board_D6; LCSC C81598
J6: CV1_IN; Board_J6; LCSC C95562
J7: GATE1_IN; Board_J7; LCSC C95562
J8: CV2_IN; Board_J8; LCSC C95562
J9: GATE2_IN; Board_J9; LCSC C95562
Q3: MMBT3904(RANGE:100-300); Board_Q3; LCSC C20526
Q4: MMBT3904(RANGE:100-300); Board_Q4; LCSC C20526
R66: 10k; Board_R66; LCSC C25804
R67: 10k; Board_R67; LCSC C25804
R68: 100k 0.1%; Board_R68; LCSC C855559
R69: 10k 0.1%; Board_R69; LCSC C95204
R70: 100k 0.1%; Board_R70; LCSC C855559
R71: 10k 0.1%; Board_R71; LCSC C95204
R72: 100k 0.1%; Board_R72; LCSC C855559
R73: 10k 0.1%; Board_R73; LCSC C95204
R74: 2.2k; Board_R74; LCSC C4190
R76: 100k; Board_R76; LCSC C25803
R77: 100k; Board_R77; LCSC C25803
R78: 10k; Board_R78; LCSC C25804
R79: 100k; Board_R79; LCSC C25803
R80: 100k; Board_R80; LCSC C25803
R81: 10k; Board_R81; LCSC C25804
U15: TLV9004IPWR CV BUFFER; Board_U15; LCSC C2058050
U16: ADS1115IDGSR; Board_U16; LCSC C37593

Connections:
+3V2: C57.1, C58.1, D3.2 (HIGH_CATHODE), D4.2 (HIGH_CATHODE), R66.1, R74.1, R78.2, R81.2, U15.4 (VCC), U16.8 (VDD); also elsewhere on the board
CV1_BUF: U15.6 (IN-_B), U15.7 (OUT_B), U16.4 (AIN0)
CV1_IN: J6.2 (TIP), R68.1
CV1_NODE: C54.1, D3.3 (COMMON), R68.2, R69.1, U15.5 (IN+_B)
CV2_BUF: U15.8 (OUT_C), U15.9 (IN-_C), U16.6 (AIN2)
CV2_IN: J8.2 (TIP), R70.1
CV2_NODE: C55.1, D4.3 (COMMON), R70.2, R71.1, U15.10 (IN+_C)
CV_BIAS: R69.2, R71.2, R73.2, U15.1 (OUT_A), U15.2 (IN-_A)
CV_BIAS_DIV: C53.1, R66.2, R67.1, U15.3 (IN+_A)
CV_REF: U15.13 (IN-_D), U15.14 (OUT_D), U16.5 (AIN1), U16.7 (AIN3)
CV_REF_NODE: C56.1, R72.2, R73.1, U15.12 (IN+_D)
GATE1_BASE: D5.1 (K), Q3.1 (B), R76.2, R77.1
GATE1_IN: J7.2 (TIP), R76.1
GATE1_N: Q3.3 (C), R78.1; also elsewhere on the board
GATE2_BASE: D6.1 (K), Q4.1 (B), R79.2, R80.1
GATE2_IN: J9.2 (TIP), R79.1
GATE2_N: Q4.3 (C), R81.1; also elsewhere on the board
GND: C53.2, C54.2, C55.2, C56.2, C57.2, C58.2, D3.1 (LOW_ANODE), D4.1 (LOW_ANODE), D5.2 (A), D6.2 (A), J6.1 (SLEEVE), J6.3 (RING_GND), J7.1 (SLEEVE), J7.3 (RING_GND), J8.1 (SLEEVE), J8.3 (RING_GND), J9.1 (SLEEVE), J9.3 (RING_GND), Q3.2 (E), Q4.2 (E), R67.2, R72.1, R74.2, R77.2, R80.2, U15.11 (VSS), U16.1 (ADDR), U16.3 (GND); also elsewhere on the board
UI_SCL: U16.10 (SCL); also elsewhere on the board
UI_SDA: U16.9 (SDA); also elsewhere on the board

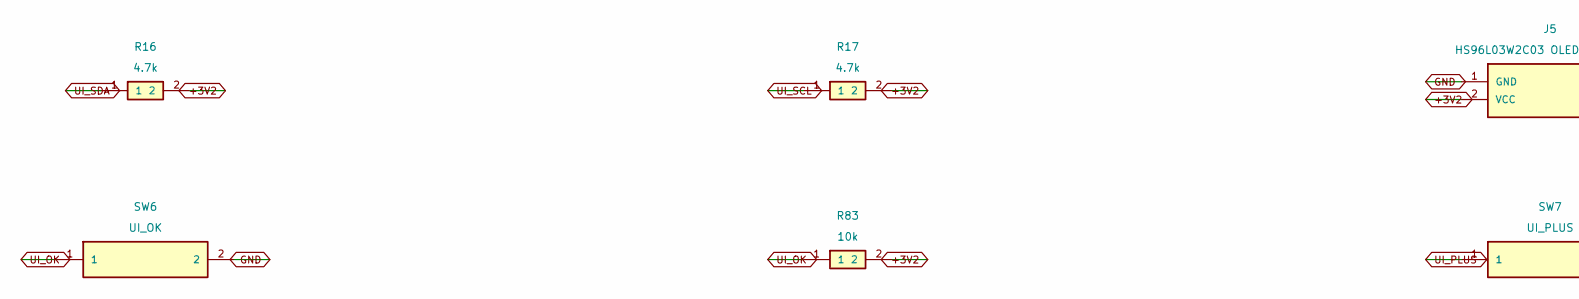
[picture p49: schematic 08.kicad_sch, OLED and controls, part in row 1, column 1]

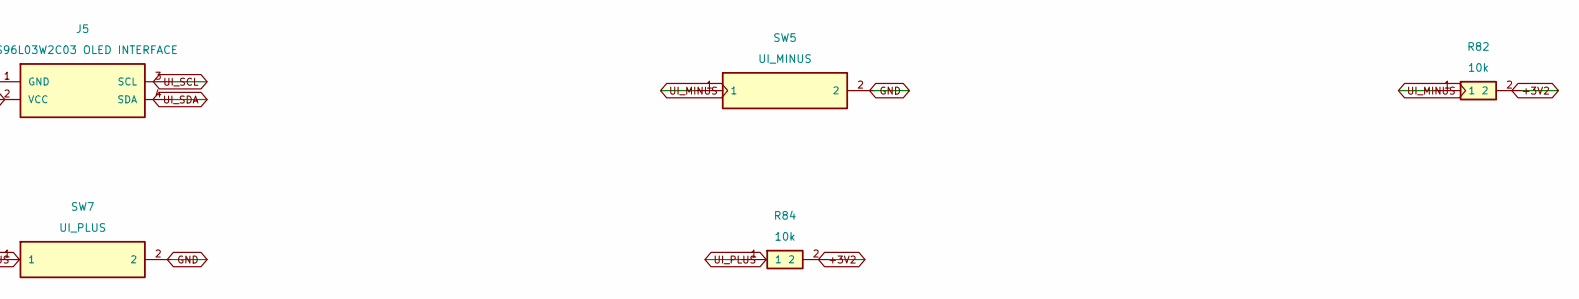
[picture p50: schematic 08.kicad_sch, OLED and controls, part in row 1, column 2]

Parts:
J5: HS96L03W2C03 OLED INTERFACE; Board_J5; LCSC C5248080
R16: 4.7k; Board_R16; LCSC C23162
R17: 4.7k; Board_R17; LCSC C23162
R82: 10k; Board_R82; LCSC C25804
R83: 10k; Board_R83; LCSC C25804
R84: 10k; Board_R84; LCSC C25804
SW5: UI_MINUS; Board_SW5; LCSC C318884
SW6: UI_OK; Board_SW6; LCSC C318884
SW7: UI_PLUS; Board_SW7; LCSC C318884

Connections:
+3V2: J5.2 (VCC), R16.2, R17.2, R82.2, R83.2, R84.2; also elsewhere on the board
GND: J5.1 (GND), SW5.2, SW6.2, SW7.2; also elsewhere on the board
UI_MINUS: R82.1, SW5.1; also elsewhere on the board
UI_OK: R83.1, SW6.1; also elsewhere on the board
UI_PLUS: R84.1, SW7.1; also elsewhere on the board
UI_SCL: J5.3 (SCL), R17.1; also elsewhere on the board
UI_SDA: J5.4 (SDA), R16.1; also elsewhere on the board

Board: 4 copper layers, 152 parts (2 on the bottom side), 96 nets, no tracks yet.

Other parts of the board:
H1: MountingHole_2.2mm_M2; Board_H1
H2: MountingHole_2.2mm_M2; Board_H2
H3: MountingHole_2.2mm_M2; Board_H3
H4: MountingHole_2.2mm_M2; Board_H4
