Bongorian/chiptune-usb-cv/firmware/tusb_config.h

#pragma once
#include "pico/stdlib.h"
#define CFG_TUSB_MCU OPT_MCU_RP2040
#define CFG_TUSB_OS OPT_OS_PICO
#define CFG_TUSB_RHPORT0_MODE (OPT_MODE_DEVICE | OPT_MODE_FULL_SPEED)
#define CFG_TUD_ENABLED 1
#define CFG_TUD_ENDPOINT0_SIZE 64
#define CFG_TUD_MIDI 1
#define CFG_TUD_MIDI_RX_BUFSIZE 256
#define CFG_TUD_MIDI_TX_BUFSIZE 256
#define CFG_TUD_CDC 0
#define CFG_TUD_MSC 0
#define CFG_TUD_HID 0
#define CFG_TUD_VENDOR 0
