Bongorian/chiptune-usb-cv/(commit log)

2026-10-05 Publish PCB design, JLCPCB manufacturing files and project documentation
    [01.kicad_sch, 02.kicad_sch, 03.kicad_sch, 04.kicad_sch, 05.kicad_sch, 06.kicad_sch, 07.kicad_sch, 08.kicad_sch]
2026-10-05 Add printable enclosure with open IC and OLED apertures
    [assembly.step, base.step, base.stl, button_cap.step, button_cap.stl, enclosure_preview.blend, fit_coupon.step, fit_coupon.stl]
2026-10-11 Add illustrated Japanese board guide
2026-10-12 Add instrument roles, stereo SN pairs and calibrated clock references
2026-10-18 feat(firmware): add three-button studio UI and ENV oscillator engine
    [engine.c, engine.h, main.c, store.c, store.h, ui.c, ui.h]
2026-10-18 fix(firmware): prevent OLED starvation in v0.5.1-alpha
    [main.c, oled.c, oled.h, service.h, test_display.c, ui.c]
2026-10-18 fix(firmware): move tracked white noise into an audible percussion range
    [engine.c, engine.h, ui.c]
2026-10-20 Fix flash capacity and make v0.8.1 startup read-only
    [check_arm_boot.py, editor.c, main.c, store.c, store.h, ui.c]
2026-10-26 Add MIDI10 mono parts, parallel SN with pan, nominal level trim and shared pitch table
    [Pitch_Table.csv]
2026-10-26 Redesign v0.10 around one resource-aware synth engine and synchronized editor
    [Pitch_Table.csv]
2026-10-26 Align direct sound controls with chip-specific waveforms and capabilities
    [Pitch_Table.csv]
